OisinS13/Peltier_rig/Hardware/BOM.xlsx

Sheet: Purchasing BOM
Sub_assembly | Quantity | Reference | Quantity | Value | Supplier | Datasheet | Description | Height | Manufacturer_Name | Manufacturer_Part_Number | Supplier Part Number | Mouser Price/Stock | Total cost | Cost per unit
Grand total |  |  |  |  |  |  |  |  |  |  |  |  | 1511.86 | 302.372
Controller | 5 |  |  |  |  |  |  |  |  |  |  |  | 195.21 | 39.042
 |  | A1 | 5 | Adafruit_Feather_Generic | Mouser | https://www.mouser.co.uk/datasheet/2/737/adafruit_adalogger_featherwing-1915269.pdf | Adafruit Accessories Adalogger FeatherWing - RTC + SD Add-on For All Feather Boards | 0 | Adafruit | 2922 | 485-2922 | 6.91 | 34.55
 |  | IC1 | 5 | MAX22531AAP+ | Mouser | https://datasheets.maximintegrated.com/en/ds/MAX22530.pdf | Field-Side Self-Powered, 4-Channel, 12-bit, Isolated ADC, 20-pin SSOP | 1.99 | Maxim Integrated | MAX22531AAP+ | 700-MAX22531AAP+ | 8.43 | 42.15
 |  | IC3 | 5 | MCP3304-CI_P | Mouser | 0 | Microchip MCP3304-CI/P, 13 bit Serial ADC, Differential Input, 16-Pin PDIP | 5.334 | Microchip | MCP3304-CI/P | 579-MCP3304-CI/P | 4.05 | 20.25
 |  | J1 J4 | 10 | Cell_V,T_Fuse | Mouser | https://www.phoenixcontact.com/us/products/1881558/pdf | Pluggable Terminal Blocks 2 Pos 2.5mm pitch Through Hole Header | 13.6 | Phoenix Contact | 1881558 | 651-1881558 | 0.926 | 9.26
 |  | J10 | 5 | NTC_ADC_Conn | Mouser | https://www.mouser.co.uk/datasheet/2/527/ssw_th-2854740.pdf | Headers & Wire Housings Tiger Buy Socket Strip with PCB Tails, .100" Pitch | 0 | Samtec | SSW-106-01-T-S | 200-SSW10601TS | 0.81 | 4.05
 |  | J11 | 5 | NTC_ADC_CS_Conn | Mouser | https://www.mouser.co.uk/datasheet/2/527/ssw_th-2854740.pdf | Headers & Wire Housings Tiger Buy Socket Strip with PCB Tails, .100" Pitch | 0 | Samtec | SSW-108-01-T-D | 200-SSW10801TD | 1.47 | 7.35
 |  | J2 J3 | 10 | I_sense_0, I_sense_1 | Mouser | https://www.phoenixcontact.com/us/products/1881451/pdf | Pluggable Terminal Blocks 3 Pos 2.5mm pitch Through Hole Header | 0 | Phoenix Contact | 1881561 | 651-1881561 | 1.05 | 10.5
 |  | J8 | 5 | LCD | Mouser | https://www.phoenixcontact.com/us/products/1881574/pdf | Pluggable Terminal Blocks 4 Pos 2.5mm pitch Through Hole Header | 0 | Phoenix Contact | 1881574 | 651-1881574 | 1.41 | 7.05
 |  | J9 | 5 | NTC_Conn | Mouser | https://tools.molex.com/pdm_docs/sd/430451622_sd.pdf | Headers & Wire Housings Microfit 3.0 RA PTH clip 15Au DR 16Ckt | 0 | Molex | 43045-1622 | 538-43045-1622 | 2.83 | 14.15
 |  | PS1 | 5 | TEA_1-0505 | Mouser | https://tracopower.com/tea1-datasheet/ | 1 Watt DC/DC converter, industrial, +/-10% input, unregulated, highly cost efficient, encapsulated, SIP-4 | 10.15 | Traco Power | TEA 1-0505 | 495-TEA1-0505 | 1.44 | 7.2
 |  | S1 S2 | 10 | DS01C-254-S-08BE | Mouser | 0 | DIP Switches / SIP Switches DIP Switch, SPST, 2.54 pitch, raised actuator, covex bottom, Short pin, 8 position, Blue | 7 | CUI Devices | DS01C-254-S-08BE | 490-DS01C-254-S-08BE | 0.571 | 5.71
 |  | U1 | 5 | Pico | Mouser | https://www.mouser.co.uk/datasheet/2/635/pico_datasheet-3048936.pdf | Single Board Computers Raspberry Pi Pico | 0 | Raspberry Pi | SC0915 | 358-SC0915 | 3.09 | 15.45
 |  | U2 U3 U4 | 15 | PXO7805-500-S | Mouser | https://www.mouser.co.uk/datasheet/2/670/pxo78_500_s-3070528.pdf | Non-Isolated DC/DC Converters dc-dc non-isolated, 0.5 A, 6.5-36 Vdc input, 5 Vdc output, SIP | 0 | CUI Inc. | PXO7805-500-S | 490-PXO7805-500-S | 1.11 | 16.65
 |  | Socket | 5 | 0 | Mouser | https://www.mouser.co.uk/datasheet/2/418/7/ENG_CD_2199298_A_baseFilename-2029528.pdf | IC & Component Sockets 16P DIP SKT 300 CL LADDER | 0 | TE Connectivity | 1-2199298-4 | 571-1-2199298-4 | 0.177 | 0.89
 |  | Socket header 12pos | 5 | 0 | Mouser | https://www.mouser.co.uk/datasheet/2/527/ssw_th-2854740.pdf | 0 | 0 | Samtec | SSW-112-01-T-S | 200-SSW11201TS | 1.48 | 7.4
 |  | Socket header 16pos | 5 | 0 | Mouser | https://www.mouser.co.uk/datasheet/2/527/ssw_th-2854740.pdf | Headers & Wire Housings Tiger Buy Socket Strip with PCB Tails, .100" Pitch | 0 | Samtec | SSW-116-01-T-S | 200-SSW11601TS | 1.89 | 9.45
 |  | Standoff | 20 | M3 x 8mm | Mouser | https://www.mouser.co.uk/datasheet/2/181/R30_300-1136135.pdf | Standoffs & Spacers M3 x 8mm HEX 5mm A/F 6mm ML/FML NICKEL | 0 | Harwin | R30-3011202 | 855-R30-3011202 | 0.504 | 10.08
 |  | SD card | 5 | 0 | Mouser | https://www.mouser.co.uk/datasheet/2/669/SanDisk_10092017_iNAND-Family-Brochure-for-M_C_022-1217148.pdf | Memory Cards 16GB UHS Class 4 MicroSD Card WD/SD | 0 | SanDisk | SDSDQAB-016G | 467-SDSDQAB-016G | 10.31 | 51.55
Driver | 5 |  |  |  |  |  |  |  |  |  |  |  | 308.07 | 61.614
 |  | C1 C2 C3 C4 C9 C10 C11 C12 | 40 | 47uF | Mouser | https://product.tdk.com/info/en/catalog/datasheets/leadmlcc_halogenfree_fg_en.pdf | Multilayer Ceramic Capacitors MLCC - Leaded RAD 25V 47uF X5R 20% LS:2.5mm | 0 | TDK | FG16X5R1E476MRT06 | 810-FG16X5R1E476MRT6 | 0.671 | 26.84
 |  | C22 C23 C24 C25 C26 C27 C28 C29 | 40 | 220uF | Mouser | https://www.mouser.co.uk/datasheet/2/231/161587830771-2307470.pdf | Aluminium Electrolytic Capacitors - Radial Leaded 25V 220uF 105C 8x11.5mm | 11.5 | Lelon | RGA221M1EBK-0811G | 140-RGA221M1EBK0811G | 0.102 | 4.08
 |  | U2 | 5 | Adafruit_815_I2C_PWM_driver | Mouser | https://www.mouser.co.uk/datasheet/2/737/PCA9685-932827.pdf | Power Management IC Development Tools PWM/Servo Driver PCA9685 12-bit | 0 | Adafruit | 815 | 485-815 | 11.54 | 57.7
 |  | J7 J12 | 10 | Conn_02x04_Odd_Even
 |  | 0 | 40 | 1377G11 | Mouser | https://www.mouser.co.uk/datasheet/2/22/DS_PP1545-1664114.pdf | Heavy Duty Power Connectors R/A PCB CONT 25A LD 0.70" - BULK | 0 | Anderson Power Products | 1377g11-bk | 879-1377G11-BK | 1.24 | 49.6
 |  | 0 | 40 | 1377G12 | Mouser | https://www.mouser.co.uk/datasheet/2/22/DS_PP1545-1664114.pdf | Heavy Duty Power Connectors R/A PCB CONT 25A LD 0.40" - BULK | 0 | Anderson Power Products | 1377g12-bk | 879-1377G12-BK | 1.24 | 49.6
 |  | 0 | 40 | 1327-BK | Mouser | https://www.mouser.co.uk/datasheet/2/22/DS_PP1545-1664114.pdf | Heavy Duty Power Connectors PP15/45 HOUSING ONLY RED - BULK | 0 | Anderson Power Products | 1327-BK | 879-1327-BK | 0.638 | 25.52
 |  | 0 | 40 | 1327G6-BK | Mouser | https://www.mouser.co.uk/datasheet/2/22/DS_PP1545-1664114.pdf | Heavy Duty Power Connectors PP15/45 HOUSING ONLY BLACK - BULK | 0 | Anderson Power Products | 1327G6-BK | 879-1327G6-BK | 0.586 | 23.44
 |  | 0 | 10 | Retaining pin | Mouser | https://www.mouser.co.uk/datasheet/2/22/DS_PP1545-1664114.pdf | Heavy Duty Power Connectors RETAINING PIN PER DWG TR1716 | 0 | Anderson Power Products | 111812P5 | 879-111812P5 | 0.189 | 1.89
 |  | 0 | 10 | Solder staple | Mouser | https://www.mouser.co.uk/datasheet/2/22/DS_PP1545-1664114.pdf | Heavy Duty Power Connectors PP15/45 23MM X 13.5MM STAPLE | 0 | Anderson Power Products | 114555P9 | 879-114555P9 | 1.01 | 10.1
 |  | 0 | 10 | Header socket 1x6 | Mouser | https://www.mouser.co.uk/datasheet/2/527/ssw_th-2854740.pdf | Headers & Wire Housings Tiger Buy Socket Strip with PCB Tails, .100" Pitch | 0 | Samtec | SSW-106-01-T-S | 200-SSW10601TS | 0.81 | 8.1
 |  | 0 | 20 | Header socket 3x4 | Mouser | https://www.mouser.co.uk/datasheet/2/527/ssw_th-2854740.pdf | Headers & Wire Housings Tiger Buy Socket Strip with PCB Tails, .100" Pitch | 0 | Samtec | SSW-104-03-F-T | 200-SSW10403FT | 2.56 | 51.2
Backplane | 5 |  |  |  |  |  |  |  |  |  |  |  | 233.49 | 46.698
 |  | C1 | 5 | 220uF | Mouser | https://www.mouser.co.uk/datasheet/2/231/161587830771-2307470.pdf | Aluminium Electrolytic Capacitors - Radial Leaded 25V 220uF 105C 8x11.5mm | 11.5 | Lelon | RGA221M1EBK-0811G | 140-RGA221M1EBK0811G | 0.102 | 0.51
 |  | J1 J2 J3 J4 J6 J7 J8 J9 | 40 | Conn_02x12_Odd_Even | Mouser | https://www.te.com/commerce/DocumentDelivery/DDEController?Action=srchrtrv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 | Standard Card Edge Connectors CONN SEC II 12 POS 100C/L | 0 | TE Connectivity | 5530843-1 | 571-5530843-1 | 1.95 | 78
 |  | J10 J11 J15 | 15 | 10046971-001LF | Mouser | https://cdn.amphenol-cs.com/media/wysiwyg/files/drawing/10046971.pdf | Power Edge Card connector, Power connectors, 2 x 32P STB Vertical | 15.49 | Amphenol Communications Solutions | 10046971-001LF | 649-10046971-001LF | 8.54 | 128.1
 |  | J12 J13 J14 | 15 | Power_switch, MCU_PWR_LED, MAIN_PWR_LED | Mouser | https://www.phoenixcontact.com/us/products/1881558/pdf | Pluggable Terminal Blocks 2 Pos 2.5mm pitch Through Hole Header | 13.6 | Phoenix Contact | 1881558 | 651-1881558 | 0.926 | 13.89
 |  | J5 | 5 | Backplane_edge_conn | Mouser | https://www.te.com/commerce/DocumentDelivery/DDEController?Action=srchrtrv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 | Standard Card Edge Connectors CONN SEC II 12 POS 100C/L | 0 | TE Connectivity | 7-5530843-5 | 571-7-5530843-5 | 2.19 | 10.95
 |  | R1 R2 R3 | 15 | 22k | Mouser | https://www.mouser.co.uk/datasheet/2/447/YAGEO_MFR_datasheet_2021v1-3003041.pdf | Metal Film Resistors - Through Hole 22.1K OHM 1/4W 1% | 0 | YAGEO | MFR-25FTE52-22K1 | 603-MFR-25FTE52-22K1 | 0.077 | 1.16
 |  | R4 | 5 | 100 | Mouser | https://www.koaspeer.com/catimages/Products/MF-MFS-RK/MF-MFS-RK.pdf | Metal Film Resistors - Through Hole 1/4 WATT 100 OHM 2% | 0 | KOA Speer | MF1/4LCT52R101G | 660-MF1/4LCT52R101G | 0.087 | 0.44
 |  | R5 | 5 | 200 | Mouser | https://www.koaspeer.com/catimages/Products/MF-MFS-RK/MF-MFS-RK.pdf | Metal Film Resistors - Through Hole 1/4 WATT 200 OHM 2% | 0 | KOA Speer | MF1/4LCT52R201G | 660-MF1/4LCT52R201G | 0.087 | 0.44
NTC_in | 5 |  |  |  |  |  |  |  |  |  |  |  | 58.69 | 11.738
 |  | IC3 | 5 | MCP3304-CI_P | Mouser | 0 | Microchip MCP3304-CI/P, 13 bit Serial ADC, Differential Input, 16-Pin PDIP | 5.334 | Microchip | MCP3304-CI/P | 579-MCP3304-CI/P | 4.05 | 20.25
 |  | J9 | 5 | NTC_Conn | Mouser | https://tools.molex.com/pdm_docs/sd/430451622_sd.pdf | Headers & Wire Housings Microfit 3.0 RA PTH clip 15Au DR 16Ckt | 0 | Molex | 43045-1622 | 538-43045-1622 | 2.83 | 14.15
 |  | S1 S2 | 10 | DS01C-254-S-08BE | Mouser | 0 | DIP Switches / SIP Switches DIP Switch, SPST, 2.54 pitch, raised actuator, covex bottom, Short pin, 8 position, Blue | 7 | CUI Devices | DS01C-254-S-08BE | 490-DS01C-254-S-08BE | 0.571 | 5.71
 |  | J10 11 | 5 | Stacking headers | Mouser | 0 | Headers & Wire Housings STACKING HEADER 1 X 26 PIN | 0 | Mikroe | MIKROE-1329 | 932-MIKROE-1329 | 1.7 | 8.5
 |  | Standoff | 20 | M3 x 8mm | Mouser | https://www.mouser.co.uk/datasheet/2/181/R30_300-1136135.pdf | Standoffs & Spacers M3 x 8mm HEX 5mm A/F 6mm ML/FML NICKEL | 0 | Harwin | R30-3011202 | 855-R30-3011202 | 0.504 | 10.08
Enclosure | 5 |  |  |  |  |  |  |  |  |  |  |  | 365.7
 |  | Enclosure | 5 | 0 | Farnell | 0 | 0 | 0 | MULTICOMP PRO | G17082UG | 1526721 | 25.68 | 128.4
 |  | USB socket | 5 | 0 | RS | 0 | 0 | 0 | RS PRO | 862-1573 | 862-1573 | 4.97 | 24.85
 |  | Micro USB cable | 5 | 0 | Mouser | 0 | 0 | 0 | Tripp Lite | UR05C-003-RB | 545-UR05C-003-RB | 7.96 | 39.8
 |  | LCD | 5 | 0 | Mouser | 0 | 0 | 0 | Seeed Studio | 104030001 | 713-104030001 | 10.53 | 52.65
 |  | PSU | 10 | 0 | https://www.bargainhardware.co.uk/ | 0 | 0 | 0 | HP | DPS-1200FB | PSU0000050 | 12 | 120
 |  | PSU carriage | 5 | 0 | 0 | 0 | 0 | 0 | 0 | 0 | 0 | 7.19 | 35.95
Boards | 5 |  |  |  |  |  |  |  |  |  |  |  | 350.7 | 70.14
 |  | Controller |  |  |  |  |  |  |  |  |  |  | 72.46 | 14.492
 |  | NTC in |  |  |  |  |  |  |  |  |  |  | 29.36 | 5.872
 |  | Driver |  |  |  |  |  |  |  |  |  |  | 193.11 | 38.622
 |  | Backplane |  |  |  |  |  |  |  |  |  |  | 30.27 | 6.054
 |  | Shipping |  |  |  |  |  |  |  |  |  |  | 25.5

Sheet: Enclosure
Component | Quantity | Value | Supplier | Datasheet | Description | Height | Manufacturer_Name | Manufacturer_Part_Number | Supplier SKU | Price
Enclosure | 1 |  | Farnell |  |  |  | MULTICOMP PRO | G17082UG | 1526721 | 25.68
USB socket | 1 |  | RS |  |  |  | RS PRO | 862-1573 | 862-1573 | 4.97
Micro USB cable | 1 |  | Mouser |  |  |  | Tripp Lite | UR05C-003-RB | 545-UR05C-003-RB | 7.96
LCD | 1 |  | Mouser |  |  |  | Seeed Studio | 104030001 | 713-104030001 | 10.53
PSU | 2 |  | https://www.bargainhardware.co.uk/ |  |  |  | HP | DPS-1200FB | PSU0000050 | 12
PSU carriage | 1 |  |  |  |  |  |  |  |  | 7.19
LCD mounting screws | 4
LCD mounting nuts | 8
USB mounting screws

Sheet: CCC_rig_NTC_in
Reference | Quantity | Value | Footprint | Datasheet | Description | Height | Manufacturer_Name | Manufacturer_Part_Number | Mouser Part Number | Mouser Price/Stock
IC2 | 1 | MCP1501T-33E_CHY | SamacSys_Parts:SOT95P270X145-6N | https://componentsearchengine.com/Datasheets/1/MCP1501T-33E_CHY.pdf | Voltage References Precision Buffered Voltage Reference | 1.45 | Microchip | MCP1501T-33E/CHY | 579-MCP1501T-33E/CHY | 0.771 (https://www.mouser.co.uk/ProductDetail/Microchip-Technology-Atmel/MCP1501T-33E-CHY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)
IC3 | 1 | MCP3304-CI_P | SamacSys_Parts:DIP781W56P254L1918H533Q16N |  | Microchip MCP3304-CI/P, 13 bit Serial ADC, Differential Input, 16-Pin PDIP | 5.334 | Microchip | MCP3304-CI/P | 579-MCP3304-CI/P | 4.05 (https://www.mouser.co.uk/ProductDetail/Microchip-Technology/MCP3304-CI-P?qs=2HbNQnvoB68T7LZcGwqiOg%3D%3D)
J9 | 1 | NTC_Conn | SamacSys_Parts:43045-16YY_212223 | https://tools.molex.com/pdm_docs/sd/430451622_sd.pdf | Headers & Wire Housings Microfit 3.0 RA PTH clip 15Au DR 16Ckt |  | Molex | 43045-1622 | 538-43045-1622 | 2.83
S1 S2 | 2 | DS01C-254-S-08BE | SamacSys_Parts:DS01C254S08BE |  | DIP Switches / SIP Switches DIP Switch, SPST, 2.54 pitch, raised actuator, covex bottom, Short pin, 8 position, Blue | 7 | CUI Devices | DS01C-254-S-08BE | 490-DS01C-254-S-08BE | 0.571
J10 11 | 1 | Stacking headers |  |  | Headers & Wire Housings STACKING HEADER 1 X 26 PIN |  | Mikroe | MIKROE-1329 | 932-MIKROE-1329 | 1.7
Standoff | 4 | M3 x 8mm |  | https://www.mouser.co.uk/datasheet/2/181/R30_300-1136135.pdf | Standoffs & Spacers M3 x 8mm HEX 5mm A/F 6mm ML/FML NICKEL |  | Harwin | R30-3011202 | 855-R30-3011202 | 0.504

Sheet: NTC_in_SMD_BOM
Comment | Designator | Footprint | JLCPCB Part #（optional）
10 nF | C11 C12 C13 C14 C15 C16 C17 C18 C19 C20 | Capacitor_SMD:C_0603_1608Metric_Pad1.08x0.95mm_HandSolder | C302008
1 uF | C21 | Capacitor_SMD:C_0603_1608Metric_Pad1.08x0.95mm_HandSolder | C15849
6.8k | R12 R13 R14 R15 R16 R17 R18 R19 | Resistor_SMD:R_0603_1608Metric_Pad0.98x0.95mm_HandSolder | C445634
REF3433IDBVR | IC2 | SamacSys_Parts:SOT95P280X145-6N | C882722

Sheet: NTC_in_SMD_SMT
Designator | Mid X | Mid Y | Layer | Rotation
C11 | 26.9 | -88.056 | top | 180
C12 | 31.9 | -88.056 | top | 180
C13 | 36.9 | -88.056 | top | 180
C14 | 41.9 | -88.056 | top | 180
C15 | 46.9 | -88.056 | top | 180
C16 | 51.9 | -88.056 | top | 180
C17 | 56.9 | -88.056 | top | 180
C18 | 61.9 | -88.056 | top | 180
C19 | 36.364 | -74.092 | top | 90
C20 | 27.728 | -74.092 | top | 90
C21 | 32.3 | -69.52 | top | 0
IC2 | 32.3 | -74.6 | top | 90
R12 | 26.9 | -84.5 | top | 180
R13 | 31.9 | -84.5 | top | 180
R14 | 36.9 | -84.5 | top | 180
R15 | 41.9 | -84.5 | top | 180
R16 | 46.9 | -84.5 | top | 180
R17 | 51.9 | -84.5 | top | 180
R18 | 56.9 | -84.5 | top | 180
R19 | 61.9 | -84.5 | top | 180

Sheet: CCC_rig_driver
Reference | Quantity | Value | Footprint | Datasheet | Description | Height | Manufacturer_Name | Manufacturer_Part_Number | Mouser Part Number | Mouser Price/Stock
C1 C2 C3 C4 C9 C10 C11 C12 | 8 | 47uF | Capacitor_THT:CP_Radial_D5.0mm_P2.50mm | https://product.tdk.com/info/en/catalog/datasheets/leadmlcc_halogenfree_fg_en.pdf | Multilayer Ceramic Capacitors MLCC - Leaded RAD 25V 47uF X5R 20% LS:2.5mm |  | TDK | FG16X5R1E476MRT06 | 810-FG16X5R1E476MRT6 | 0.671
C22 C23 C24 C25 C26 C27 C28 C29 | 8 | 220uF | Capacitor_THT:CP_Radial_D8.0mm_P3.50mm | https://www.mouser.co.uk/datasheet/2/231/161587830771-2307470.pdf | Aluminium Electrolytic Capacitors - Radial Leaded 25V 220uF 105C 8x11.5mm | 11.5 | Lelon | RGA221M1EBK-0811G | 140-RGA221M1EBK0811G | 0.102
U2 | 1 | Adafruit_815_I2C_PWM_driver | Arduino:MODULE_815 | https://www.mouser.co.uk/datasheet/2/737/PCA9685-932827.pdf | Power Management IC Development Tools PWM/Servo Driver PCA9685 12-bit |  | Adafruit | 815 | 485-815 | 11.54
J7 J12 | 2 | Conn_02x04_Odd_Even | SamacSys_Parts:Anderson_PCB_mount_P1545_2x4
 | 8 | 1377G11 |  | https://www.mouser.co.uk/datasheet/2/22/DS_PP1545-1664114.pdf | Heavy Duty Power Connectors R/A PCB CONT 25A LD 0.70" - BULK |  | Anderson Power Products | 1377g11-bk | 879-1377G11-BK | 1.24
 | 8 | 1377G12 |  | https://www.mouser.co.uk/datasheet/2/22/DS_PP1545-1664114.pdf | Heavy Duty Power Connectors R/A PCB CONT 25A LD 0.40" - BULK |  | Anderson Power Products | 1377g12-bk | 879-1377G12-BK | 1.24
 | 8 | 1327-BK |  | https://www.mouser.co.uk/datasheet/2/22/DS_PP1545-1664114.pdf | Heavy Duty Power Connectors PP15/45 HOUSING ONLY RED - BULK |  | Anderson Power Products | 1327-BK | 879-1327-BK | 0.638
 | 8 | 1327G6-BK |  | https://www.mouser.co.uk/datasheet/2/22/DS_PP1545-1664114.pdf | Heavy Duty Power Connectors PP15/45 HOUSING ONLY BLACK - BULK |  | Anderson Power Products | 1327G6-BK | 879-1327G6-BK | 0.586
 | 2 | Retaining pin |  | https://www.mouser.co.uk/datasheet/2/22/DS_PP1545-1664114.pdf | Heavy Duty Power Connectors RETAINING PIN PER DWG TR1716 |  | Anderson Power Products | 111812P5 | 879-111812P5 | 0.189
 | 2 | Solder staple |  | https://www.mouser.co.uk/datasheet/2/22/DS_PP1545-1664114.pdf | Heavy Duty Power Connectors PP15/45 23MM X 13.5MM STAPLE |  | Anderson Power Products | 114555P9 | 879-114555P9 | 1.01
 | 2 | Header socket 1x6 |  | https://www.mouser.co.uk/datasheet/2/527/ssw_th-2854740.pdf | Headers & Wire Housings Tiger Buy Socket Strip with PCB Tails, .100" Pitch |  | Samtec | SSW-106-01-T-S | 200-SSW10601TS | 0.81
 | 4 | Header socket 3x4 |  | https://www.mouser.co.uk/datasheet/2/527/ssw_th-2854740.pdf | Headers & Wire Housings Tiger Buy Socket Strip with PCB Tails, .100" Pitch |  | Samtec | SSW-104-03-F-T | 200-SSW10403FT | 2.56

Sheet: Driver_SMD_BOM
Comment | Designator | Footprint | JLCPCB Part #（optional）
VNH7070ASTR | SamacSys_Parts:SOIC127P600X175-16N-layout | SamacSys_Parts:SOIC127P600X175-16N-layout | C2150622
BSS138 | Q3 Q4 Q5 Q6 Q7 Q8 Q9 Q10 | Package_TO_SOT_SMD:SOT-23 | C112239
8.06k | R20 R21 R22 R23 R24 R25 R26 R27 | Resistor_SMD:R_0603_1608Metric_Pad0.98x0.95mm_HandSolder | C861587
1k | R28 R29 R30 R31 R32 R33 R34 R35 R36 R37 R38 R39 R40 R41 R42 R43 R44 R45 R46 R47 R48 R49 R50 R51 | Resistor_SMD:R_0603_1608Metric_Pad0.98x0.95mm_HandSolder | C22548

Sheet: Driver_SMD_SMT
Designator | Mid X | Mid Y | Layer | Rotation
IC4 | 26.4175 | -30.1876 | top | 90
IC5 | 33.0361 | -49.5528 | top | 90
IC6 | 39.6547 | -68.918 | top | 90
IC7 | 46.2733 | -88.2832 | top | 90
IC8 | 58.2477 | -150.0569 | top | -90
IC9 | 64.6644 | -130.6917 | top | -90
IC10 | 71.081 | -111.3265 | top | -90
IC11 | 77.4977 | -91.9613 | top | -90
J6 | 48 | -11.9946 | top | 180
Q3 | 39.6675 | -26.0251 | top | 0
Q4 | 46.2861 | -45.3903 | top | 0
Q5 | 52.9047 | -64.7555 | top | 0
Q6 | 59.5233 | -84.1207 | top | 0
Q7 | 50.5 | -157.9 | top | 180
Q8 | 51.4144 | -134.8542 | top | 180
Q9 | 57.831 | -115.489 | top | 180
Q10 | 64.2477 | -96.1238 | top | 180
R20 | 35.6675 | -26.0251 | top | -90
R21 | 42.2861 | -45.3903 | top | -90
R22 | 48.9047 | -64.7555 | top | -90
R23 | 55.5233 | -84.1207 | top | -90
R24 | 48.9977 | -154.2194 | top | 90
R25 | 55.4144 | -134.8542 | top | 90
R26 | 61.831 | -115.489 | top | 90
R27 | 68.2477 | -96.1238 | top | 90
R28 | 33.505 | -32.1876 | top | 180
R29 | 40.1236 | -51.5528 | top | 180
R30 | 46.7422 | -70.918 | top | 180
R31 | 53.3608 | -90.2832 | top | 180
R32 | 32.6675 | -26.0251 | top | -90
R33 | 39.2861 | -45.3903 | top | -90
R34 | 45.9047 | -64.7555 | top | -90
R35 | 52.5233 | -84.1207 | top | -90
R36 | 18.4175 | -28.4376 | top | 180
R37 | 25.0361 | -47.8028 | top | 180
R38 | 31.6547 | -67.168 | top | 180
R39 | 38.2733 | -86.5332 | top | 180
R40 | 51.1602 | -148.0569 | top | 0
R41 | 57.5769 | -128.6917 | top | 0
R42 | 63.9935 | -109.3265 | top | 0
R43 | 70.4102 | -89.9613 | top | 0
R44 | 51.9977 | -154.2194 | top | 90
R45 | 58.4144 | -134.8542 | top | 90
R46 | 64.831 | -115.489 | top | 90
R47 | 71.2477 | -96.1238 | top | 90
R48 | 66.2477 | -151.8069 | top | 0
R49 | 72.6644 | -132.4417 | top | 0
R50 | 79.0814 | -113.0767 | top | 0
R51 | 85.4977 | -93.7113 | top | 0

Sheet: CCC_rig_backplane
Reference | Quantity | Value | Footprint | Datasheet | Description | Height | Manufacturer_Name | Manufacturer_Part_Number | Mouser Part Number | Mouser Price/Stock
C1 | 1 | 220uF | Capacitor_THT:CP_Radial_D8.0mm_P3.50mm | https://www.mouser.co.uk/datasheet/2/231/161587830771-2307470.pdf | Aluminium Electrolytic Capacitors - Radial Leaded 25V 220uF 105C 8x11.5mm | 11.5 | Lelon | RGA221M1EBK-0811G | 140-RGA221M1EBK0811G | 0.102
J1 J2 J3 J4 J6 J7 J8 J9 | 8 | Conn_02x12_Odd_Even | SamacSys_Parts:55308431 | https://www.te.com/commerce/DocumentDelivery/DDEController?Action=srchrtrv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 | Standard Card Edge Connectors CONN SEC II 12 POS 100C/L |  | TE Connectivity | 5530843-1 | 571-5530843-1 | 1.95
J10 J11 J15 | 3 | 10046971-001LF | SamacSys_Parts:RHDR64W90P508X254_2X32_8786X929X1549P | https://cdn.amphenol-cs.com/media/wysiwyg/files/drawing/10046971.pdf | Power Edge Card connector, Power connectors, 2 x 32P STB Vertical | 15.49 | Amphenol Communications Solutions | 10046971-001LF | 649-10046971-001LF | 8.54
J12 J13 J14 | 3 | Power_switch, MCU_PWR_LED, MAIN_PWR_LED | SamacSys_Parts:1963531 | https://www.phoenixcontact.com/us/products/1881558/pdf | Pluggable Terminal Blocks 2 Pos 2.5mm pitch Through Hole Header | 13.6 | Phoenix Contact | 1881558 | 651-1881558 | 0.926
J5 | 1 | Backplane_edge_conn | SamacSys_Parts:755308435 | https://www.te.com/commerce/DocumentDelivery/DDEController?Action=srchrtrv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 | Standard Card Edge Connectors CONN SEC II 12 POS 100C/L |  | TE Connectivity | 7-5530843-5 | 571-7-5530843-5 | 2.19
R1 R2 R3 | 3 | 22k | Resistor_THT:R_Axial_DIN0207_L6.3mm_D2.5mm_P7.62mm_Horizontal | https://www.mouser.co.uk/datasheet/2/447/YAGEO_MFR_datasheet_2021v1-3003041.pdf | Metal Film Resistors - Through Hole 22.1K OHM 1/4W 1% |  | YAGEO | MFR-25FTE52-22K1 | 603-MFR-25FTE52-22K1 | 0.077
R4 | 1 | 100 | Resistor_THT:R_Axial_DIN0207_L6.3mm_D2.5mm_P7.62mm_Horizontal | https://www.koaspeer.com/catimages/Products/MF-MFS-RK/MF-MFS-RK.pdf | Metal Film Resistors - Through Hole 1/4 WATT 100 OHM 2% |  | KOA Speer | MF1/4LCT52R101G | 660-MF1/4LCT52R101G | 0.087
R5 | 1 | 200 | Resistor_THT:R_Axial_DIN0207_L6.3mm_D2.5mm_P7.62mm_Horizontal | https://www.koaspeer.com/catimages/Products/MF-MFS-RK/MF-MFS-RK.pdf | Metal Film Resistors - Through Hole 1/4 WATT 200 OHM 2% |  | KOA Speer | MF1/4LCT52R201G | 660-MF1/4LCT52R201G | 0.087

Sheet: CCC_rig_controller
Reference | Quantity | Value | Footprint | Datasheet | Description | Height | Manufacturer_Name | Manufacturer_Part_Number | Mouser Part Number | Mouser Price/Stock
A1 | 1 | Adafruit_Feather_Generic | Module:Adafruit_Feather | https://www.mouser.co.uk/datasheet/2/737/adafruit_adalogger_featherwing-1915269.pdf | Adafruit Accessories Adalogger FeatherWing - RTC + SD Add-on For All Feather Boards |  | Adafruit | 2922 | 485-2922 | 6.91
IC1 | 1 | MAX22531AAP+ | SamacSys_Parts:SOP65P778X199-20N | https://datasheets.maximintegrated.com/en/ds/MAX22530.pdf | Field-Side Self-Powered, 4-Channel, 12-bit, Isolated ADC, 20-pin SSOP | 1.99 | Maxim Integrated | MAX22531AAP+ | 700-MAX22531AAP+ | 8.43 (https://www.mouser.co.uk/ProductDetail/Maxim-Integrated/MAX22531AAP%2b?qs=doiCPypUmgFZ7xzUXZ7H2g%3D%3D)
IC3 | 1 | MCP3304-CI_P | SamacSys_Parts:DIP781W56P254L1918H533Q16N |  | Microchip MCP3304-CI/P, 13 bit Serial ADC, Differential Input, 16-Pin PDIP | 5.334 | Microchip | MCP3304-CI/P | 579-MCP3304-CI/P | 4.05 (https://www.mouser.co.uk/ProductDetail/Microchip-Technology/MCP3304-CI-P?qs=2HbNQnvoB68T7LZcGwqiOg%3D%3D)
J1 J4 | 2 | Cell_V,T_Fuse | SamacSys_Parts:1963531 | https://www.phoenixcontact.com/us/products/1881558/pdf | Pluggable Terminal Blocks 2 Pos 2.5mm pitch Through Hole Header | 13.6 | Phoenix Contact | 1881558 | 651-1881558 | 0.926
J10 | 1 | NTC_ADC_Conn | Connector_PinSocket_2.54mm:PinSocket_1x06_P2.54mm_Vertical | https://www.mouser.co.uk/datasheet/2/527/ssw_th-2854740.pdf | Headers & Wire Housings Tiger Buy Socket Strip with PCB Tails, .100" Pitch |  | Samtec | SSW-106-01-T-S | 200-SSW10601TS | 0.81
J11 | 1 | NTC_ADC_CS_Conn | Connector_PinSocket_2.54mm:PinSocket_2x08_P2.54mm_Vertical | https://www.mouser.co.uk/datasheet/2/527/ssw_th-2854740.pdf | Headers & Wire Housings Tiger Buy Socket Strip with PCB Tails, .100" Pitch |  | Samtec | SSW-108-01-T-D | 200-SSW10801TD | 1.47
J2 J3 | 2 | I_sense_0, I_sense_1 | SamacSys_Parts:1963544 | https://www.phoenixcontact.com/us/products/1881451/pdf | Pluggable Terminal Blocks 3 Pos 2.5mm pitch Through Hole Header |  | Phoenix Contact | 1881561 | 651-1881561 | 1.05
J8 | 1 | LCD | SamacSys_Parts:1963557 | https://www.phoenixcontact.com/us/products/1881574/pdf | Pluggable Terminal Blocks 4 Pos 2.5mm pitch Through Hole Header |  | Phoenix Contact | 1881574 | 651-1881574 | 1.41
J9 | 1 | NTC_Conn | SamacSys_Parts:43045-16YY_212223 | https://tools.molex.com/pdm_docs/sd/430451622_sd.pdf | Headers & Wire Housings Microfit 3.0 RA PTH clip 15Au DR 16Ckt |  | Molex | 43045-1622 | 538-43045-1622 | 2.83
PS1 | 1 | TEA_1-0505 | SamacSys_Parts:TEA10505 | https://tracopower.com/tea1-datasheet/ | 1 Watt DC/DC converter, industrial, +/-10% input, unregulated, highly cost efficient, encapsulated, SIP-4 | 10.15 | Traco Power | TEA 1-0505 | 495-TEA1-0505 | 1.44
S1 S2 | 2 | DS01C-254-S-08BE | SamacSys_Parts:DS01C254S08BE |  | DIP Switches / SIP Switches DIP Switch, SPST, 2.54 pitch, raised actuator, covex bottom, Short pin, 8 position, Blue | 7 | CUI Devices | DS01C-254-S-08BE | 490-DS01C-254-S-08BE | 0.571
U1 | 1 | Pico | MCU_RaspberryPi_and_Boards:RPi_Pico_SMD_TH | https://www.mouser.co.uk/datasheet/2/635/pico_datasheet-3048936.pdf | Single Board Computers Raspberry Pi Pico |  | Raspberry Pi | SC0915 | 358-SC0915 | 3.09
U2 U3 U4 | 3 | PXO7805-500-S | SamacSys_Parts:PXO7805-500-S | https://www.mouser.co.uk/datasheet/2/670/pxo78_500_s-3070528.pdf | Non-Isolated DC/DC Converters dc-dc non-isolated, 0.5 A, 6.5-36 Vdc input, 5 Vdc output, SIP |  | CUI Inc. | PXO7805-500-S | 490-PXO7805-500-S | 1.11
Socket | 1 |  |  | https://www.mouser.co.uk/datasheet/2/418/7/ENG_CD_2199298_A_baseFilename-2029528.pdf | IC & Component Sockets 16P DIP SKT 300 CL LADDER |  | TE Connectivity | 1-2199298-4 | 571-1-2199298-4 | 0.177
Socket header 12pos | 1 |  |  | https://www.mouser.co.uk/datasheet/2/527/ssw_th-2854740.pdf |  |  | Samtec | SSW-112-01-T-S | 200-SSW11201TS | 1.48
Socket header 16pos | 1 |  |  | https://www.mouser.co.uk/datasheet/2/527/ssw_th-2854740.pdf | Headers & Wire Housings Tiger Buy Socket Strip with PCB Tails, .100" Pitch |  | Samtec | SSW-116-01-T-S | 200-SSW11601TS | 1.89
Standoff | 4 | M3 x 8mm |  | https://www.mouser.co.uk/datasheet/2/181/R30_300-1136135.pdf | Standoffs & Spacers M3 x 8mm HEX 5mm A/F 6mm ML/FML NICKEL |  | Harwin | R30-3011202 | 855-R30-3011202 | 0.504
SD card | 1 |  |  | https://www.mouser.co.uk/datasheet/2/669/SanDisk_10092017_iNAND-Family-Brochure-for-M_C_022-1217148.pdf | Memory Cards 16GB UHS Class 4 MicroSD Card WD/SD |  | SanDisk | SDSDQAB-016G | 467-SDSDQAB-016G | 10.31

Sheet: Controller_SMD_BOM
Comment | Designator | Footprint | JLCPCB Part #（optional）
10 nF | C1 C2 C3 C6 C7 C10 C11 C12 C13 C14 C15 C16 C17 C18 C19 C20 | Capacitor_SMD:C_0603_1608Metric_Pad1.08x0.95mm_HandSolder | C302008
1 uF | C4 C5 C8 C21 | Capacitor_SMD:C_0603_1608Metric_Pad1.08x0.95mm_HandSolder | C15849
22 pF | C9 | Capacitor_SMD:C_0603_1608Metric_Pad1.08x0.95mm_HandSolder | C105620
BSS138 | Q1 Q2 | Package_TO_SOT_SMD:SOT-23 | C112239
14k | R1 R3 R4 | Resistor_SMD:R_0603_1608Metric_Pad0.98x0.95mm_HandSolder | C705811
6.8k | R12 R13 R14 R15 R16 R17 R18 R19 | Resistor_SMD:R_0603_1608Metric_Pad0.98x0.95mm_HandSolder | C445634
12k | R2 | Resistor_SMD:R_0603_1608Metric_Pad0.98x0.95mm_HandSolder | C413722
8.06k | R5 R6 R7 | Resistor_SMD:R_0603_1608Metric_Pad0.98x0.95mm_HandSolder | C861587
5.6k | R8 R9 R10 R11 | Resistor_SMD:R_0603_1608Metric_Pad0.98x0.95mm_HandSolder | C351638
REF3433IDBVR | IC2 | SamacSys_Parts:SOT95P280X145-6N | C882722

Sheet: Controller_SMD_SMT
Designator | Mid X | Mid Y | Layer | Rotation
C1 | 76.392 | -39.9633 | top | 90
C2 | 73.344 | -39.8098 | top | 90
C3 | 70.296 | -39.8098 | top | 90
C4 | 67.248 | -39.8098 | top | 90
C5 | 79.44 | -39.9633 | top | -90
C6 | 64.2 | -39.8098 | top | 90
C7 | 82.488 | -39.9633 | top | -90
C8 | 69.128 | -52.6138 | top | 90
C9 | 79.128 | -55.6138 | top | 180
C10 | 66.08 | -52.6138 | top | 90
C11 | 50.7 | -179.956 | top | 180
C12 | 55.7 | -179.956 | top | 180
C13 | 60.7 | -179.956 | top | 180
C14 | 65.7 | -179.956 | top | 180
C15 | 70.7 | -179.956 | top | 180
C16 | 75.7 | -179.956 | top | 180
C17 | 80.7 | -179.956 | top | 180
C18 | 85.7 | -179.956 | top | 180
C19 | 60.164 | -165.992 | top | 90
C20 | 51.528 | -165.992 | top | 90
C21 | 56.1 | -161.42 | top | 0
Q1 | 84.024 | -81.7808 | top | 0
Q2 | 84 | -92.2088 | top | 0
R1 | 78.5 | -69.6263 | top | -90
R2 | 76.392 | -34.7298 | top | -90
R3 | 70.296 | -34.7298 | top | -90
R4 | 64.2 | -34.7298 | top | -90
R5 | 79.44 | -34.7298 | top | 90
R6 | 73.344 | -34.7298 | top | 90
R7 | 67.248 | -34.7298 | top | 90
R8 | 88.596 | -81.7808 | top | 90
R9 | 82.5 | -77.2088 | top | -90
R10 | 88.5 | -92.7888 | top | 90
R11 | 82.5 | -87.7088 | top | -90
R12 | 50.7 | -176.4 | top | 180
R13 | 55.7 | -176.4 | top | 180
R14 | 60.7 | -176.4 | top | 180
R15 | 65.7 | -176.4 | top | 180
R16 | 70.7 | -176.4 | top | 180
R17 | 75.7 | -176.4 | top | 180
R18 | 80.7 | -176.4 | top | 180
R19 | 85.7 | -176.4 | top | 180
IC2 | 56.1 | -166.5 | top | 90
