OisinS13/Peltier_rig/Hardware/CCC_rig_backplane/CAD_sketch.dxf

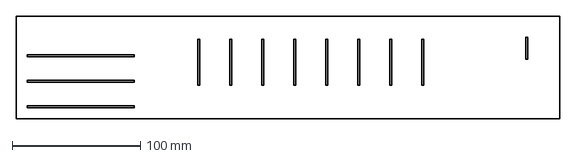
[picture p1: CAD file, 2023-10-16]
Hardware/CCC_rig_backplane/CAD_sketch.dxf
424.0 x 80.0 mm
