OisinS13/Peltier_rig/Hardware/CCC_rig_driver/CCC_rig_driver.step

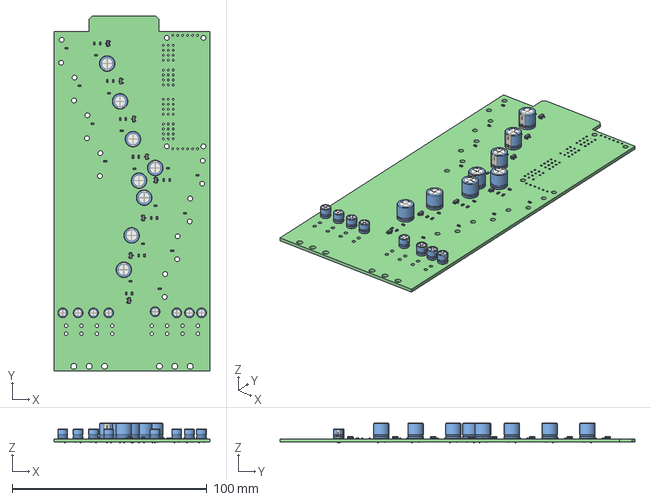
[picture p2: CAD file, 2023-10-16]
Hardware/CCC_rig_driver/CCC_rig_driver.step
80.0 x 182.0 x 10.0 mm
CCC_rig_driver PCB
