OisinS13/Peltier_rig/Hardware/CCC_rig_NTC_in/CCC_rig_NTC_in.step

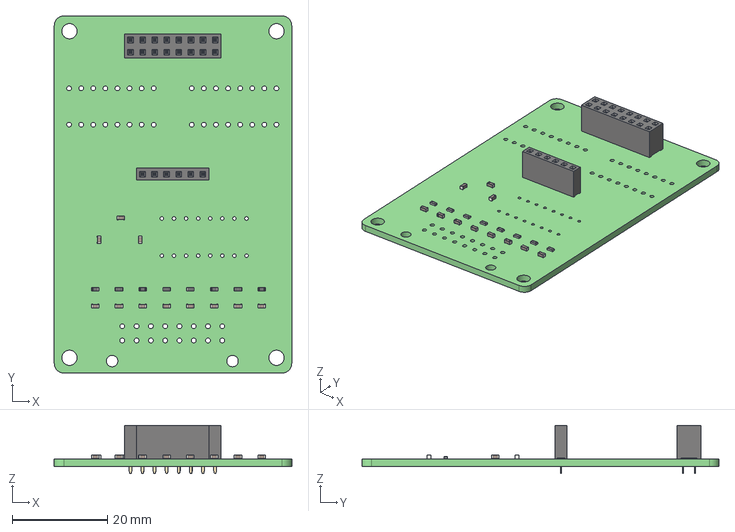
[picture p3: CAD file, 2023-10-16]
Hardware/CCC_rig_NTC_in/CCC_rig_NTC_in.step
49.9 x 75.0 x 10.1 mm
CCC_rig_NTC_in PCB
