OisinS13/Peltier_rig/Hardware/CCC_rig_NTC_in/Fab_outs_NTC/CCC_rig_NTC_in-NPTH-drl-drl_map.dxf

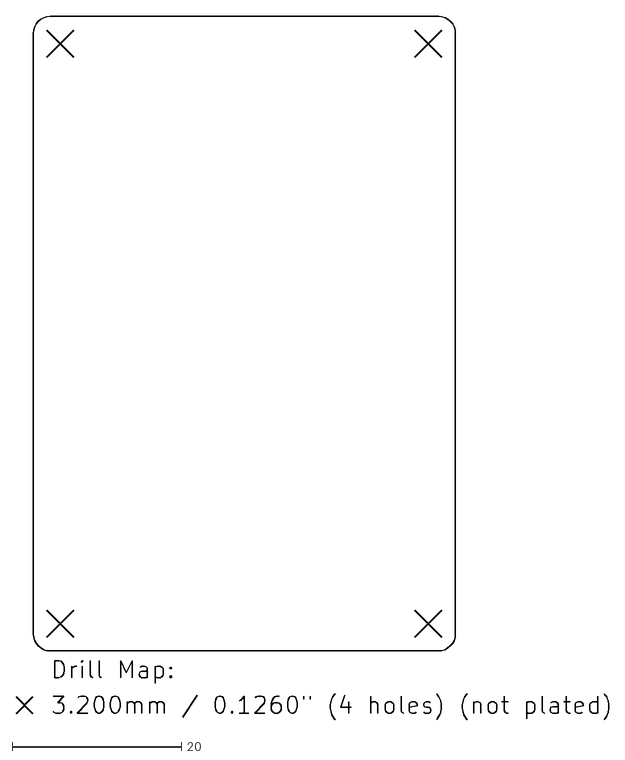
[picture p4: CAD file, 2023-10-16]
Hardware/CCC_rig_NTC_in/Fab_outs_NTC/CCC_rig_NTC_in-NPTH-drl-drl_map.dxf
70.1 x 83.1
