OisinS13/Peltier_rig/Hardware/CCC_rig_backplane/AndersonPP45 v2.step

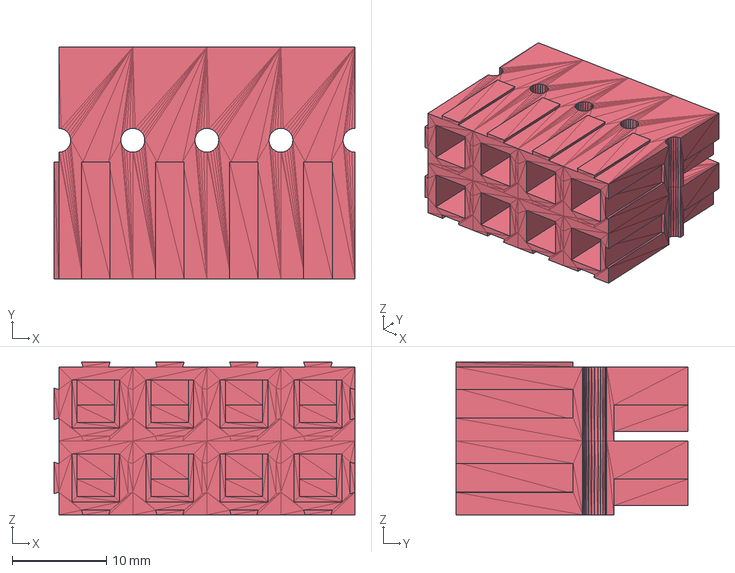
[picture p5: CAD file, 2023-10-16]
Hardware/CCC_rig_backplane/AndersonPP45 v2.step
32.0 x 24.6 x 16.3 mm
