OisinS13/Peltier_rig/Hardware/CCC_rig_NTC_in/Fab_outs_NTC/CCC_rig_NTC_in-PTH-drl-drl_map.dxf

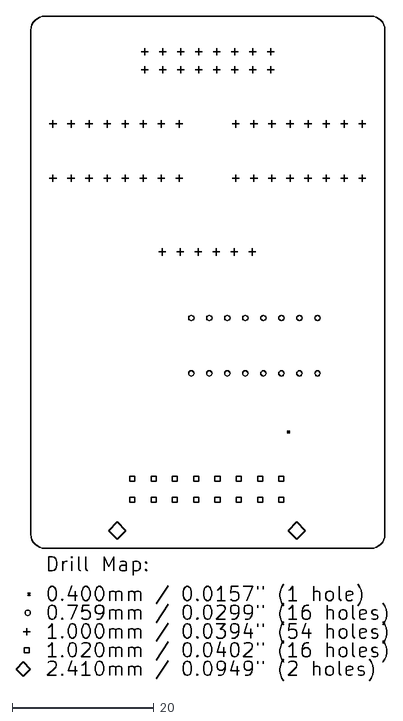
[picture p6: CAD file, 2023-10-16]
Hardware/CCC_rig_NTC_in/Fab_outs_NTC/CCC_rig_NTC_in-PTH-drl-drl_map.dxf
52.2 x 93.7
