OisinS13/Peltier_rig/(list of files, drawings)

Other design files:
Hardware/CCC_rig_backplane/CCC_rig_backplane.dsn
Hardware/CCC_rig_controller/CCC_rig_controller/CCC_rig_controller.dsn
Hardware/CCC_rig_controller/CCC_rig_controller/CCC_rig_controller_test.dsn
Hardware/CCC_rig_driver/CCC_rig_driver.dsn
Hardware/CCC_rig_NTC_in/CCC_rig_NTC_in.dsn
