OisinS13/Peltier_rig/Hardware/CCC_rig_NTC_in/CCC_rig_NTC_in.kicad_pcb

## KiCad design Hardware/CCC_rig_NTC_in/CCC_rig_NTC_in.kicad_pcb (2023-10-16)

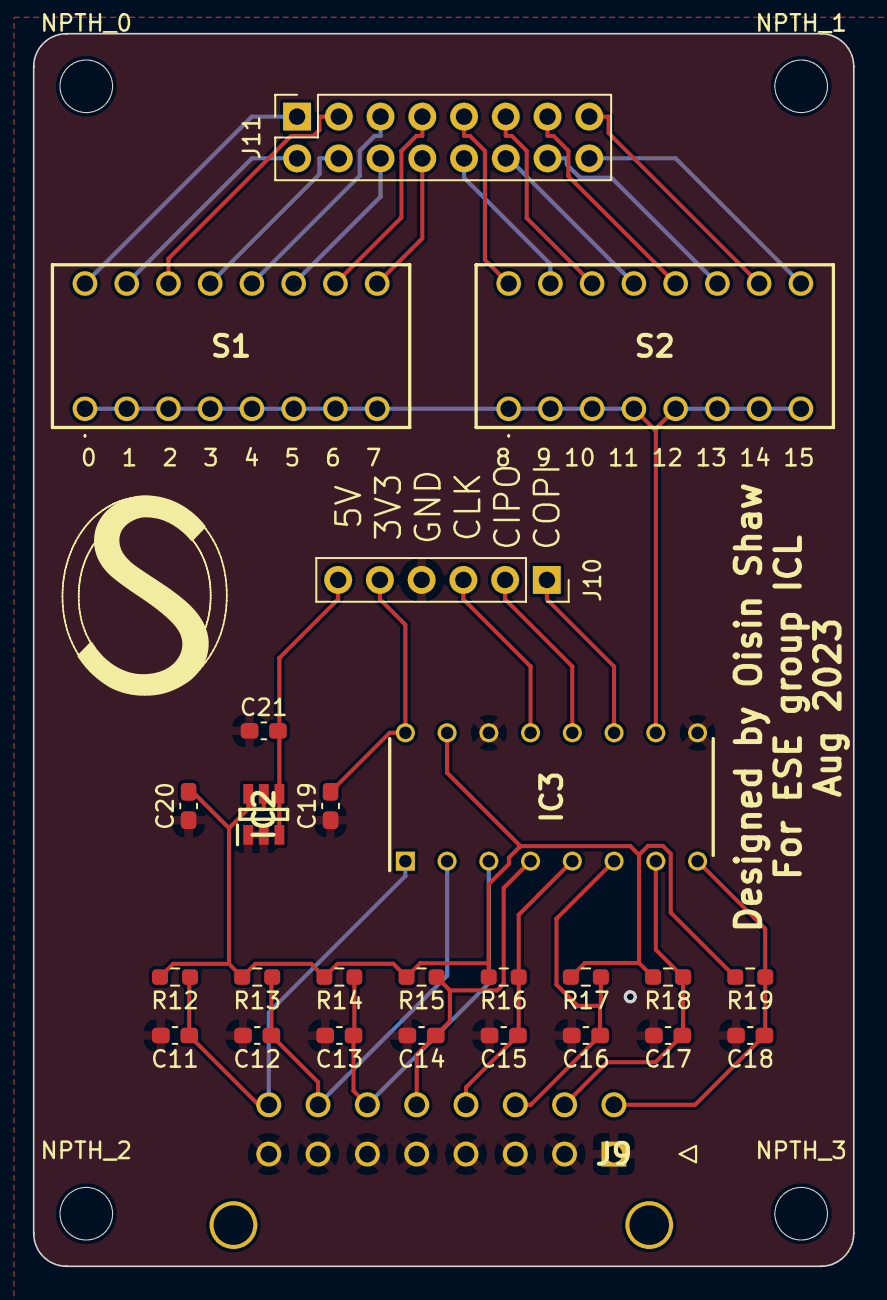
[picture p7: board CCC_rig_NTC_in.kicad_pcb from above]

Board: 2 copper layers, 49.9 x 75.0 mm, 30 parts (0 on the bottom side), 32 nets.

Parts:
C11, C12, C13, C14, C15, C16, C17, C18, C19, C20: 10 nF; C_0603_1608Metric_Pad1.08x0.95mm_HandSolder
C21: 1 uF; C_0603_1608Metric_Pad1.08x0.95mm_HandSolder
IC2: REF3433IDBVR; SOT95P280X145-6N
IC3: MCP3304-CI_P; DIP781W56P254L1918H533Q16N
J9: NTC_Conn; 43045-16YY_212223
J10: NTC_ADC_Conn; PinSocket_1x06_P2.54mm_Vertical
J11: NTC_ADC_CS_Conn; PinSocket_2x08_P2.54mm_Vertical
NPTH_0, NPTH_1, NPTH_2, NPTH_3: MountingHole_3.2mm_M3_ISO7380
R12, R13, R14, R15, R16, R17, R18, R19: 6.8k; R_0603_1608Metric_Pad0.98x0.95mm_HandSolder
S1, S2: DS01C-254-S-08BE; DS01C254S08BE

Connections:
3V3_ref_NTC_ADC: C20.2, IC2.5 (OUT_S), IC2.6 (OUT_F), IC3.15 (VREF), R12.2, R13.2, R14.2, R15.2, R16.2, R17.2, R18.2, R19.2
+3.3V: C19.2, IC3.16 (VDD), J10.5
+5V: C21.2, IC2.3 (ENABLE), IC2.4 (IN), J10.6
ADC_SPI_CLK: IC3.13 (CLK), J10.3
ADC_SPI_MISO: IC3.12 (DOUT), J10.2
ADC_SPI_MOSI: IC3.11 (DIN), J10.1
GNDD: C11.2, C12.2, C13.2, C14.2, C15.2, C16.2, C17.2, C18.2, C19.1, C20.1, C21.1, IC2.1 (GND_F), IC2.2 (GND_S), IC3.9 (DGND), IC3.14 (AGND), J9.1, J9.2, J9.3, J9.4, J9.5, J9.6, J9.7, J9.8, J10.4
NTC_ADC_CH0: C11.1, IC3.1 (CH0), J9.16, R12.1
NTC_ADC_CH1: C12.1, IC3.2 (CH1), J9.15, R13.1
NTC_ADC_CH2: C13.1, IC3.3 (CH2), J9.14, R14.1
NTC_ADC_CH3: C14.1, IC3.4 (CH3), J9.13, R15.1
NTC_ADC_CH4: C15.1, IC3.5 (CH4), J9.12, R16.1
NTC_ADC_CH5: C16.1, IC3.6 (CH5), J9.11, R17.1
NTC_ADC_CH6: C17.1, IC3.7 (CH6), J9.10, R18.1
NTC_ADC_CH7: C18.1, IC3.8 (CH7), J9.9, R19.1
NTC_ADC_CS: IC3.10 (~CS/SHDN), S1.1 (COM_1), S1.3 (COM_2), S1.5 (COM_3), S1.7 (COM_4), S1.9 (COM_5), S1.11 (COM_6), S1.13 (COM_7), S1.15 (COM_8), S2.1 (COM_1), S2.3 (COM_2), S2.5 (COM_3), S2.7 (COM_4), S2.9 (COM_5), S2.11 (COM_6), S2.13 (COM_7), S2.15 (COM_8)
NTC_ADC_CS_00: J11.1, S1.2 (NO_1)
NTC_ADC_CS_01: J11.2, S1.4 (NO_2)
NTC_ADC_CS_02: J11.3, S1.6 (NO_3)
NTC_ADC_CS_03: J11.4, S1.8 (NO_4)
NTC_ADC_CS_04: J11.5, S1.10 (NO_5)
NTC_ADC_CS_05: J11.6, S1.12 (NO_6)
NTC_ADC_CS_06: J11.7, S1.14 (NO_7)
NTC_ADC_CS_07: J11.8, S1.16 (NO_8)
NTC_ADC_CS_08: J11.9, S2.2 (NO_1)
NTC_ADC_CS_09: J11.10, S2.4 (NO_2)
NTC_ADC_CS_10: J11.11, S2.6 (NO_3)
NTC_ADC_CS_11: J11.12, S2.8 (NO_4)
NTC_ADC_CS_12: J11.13, S2.10 (NO_5)
NTC_ADC_CS_13: J11.14, S2.12 (NO_6)
NTC_ADC_CS_14: J11.15, S2.14 (NO_7)
NTC_ADC_CS_15: J11.16, S2.16 (NO_8)
