OisinS13/Peltier_rig/Hardware/CCC_rig_driver/CCC_rig_driver.kicad_pcb

## KiCad design Hardware/CCC_rig_driver/CCC_rig_driver.kicad_pcb (2023-10-16)

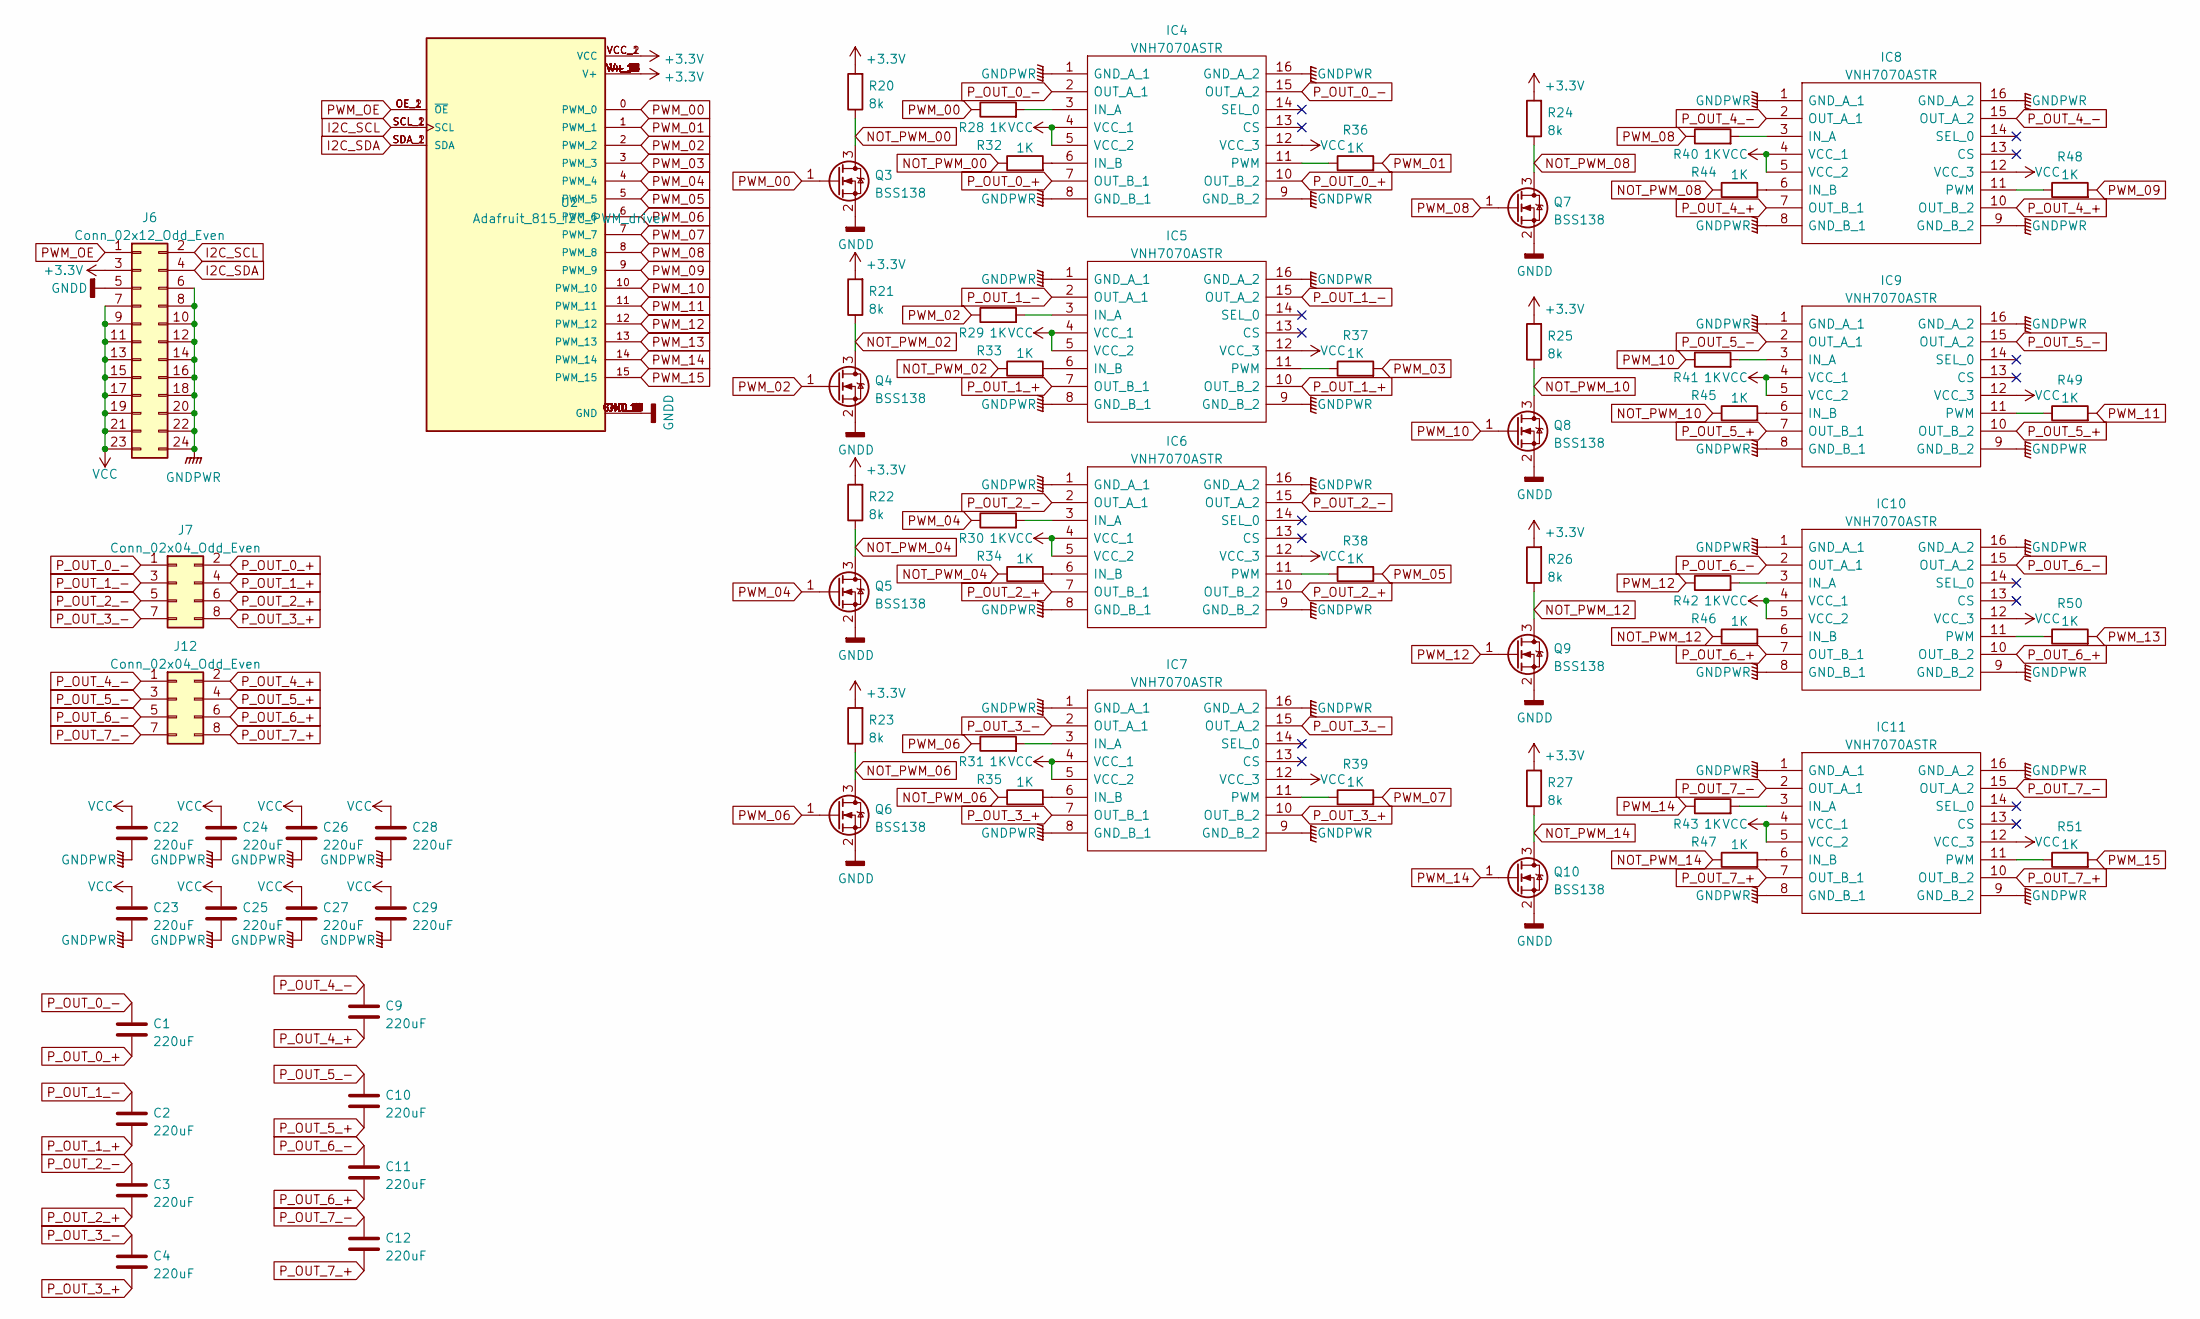
[picture p8: schematic CCC_rig_driver.kicad_sch]

Parts:
C1, C2, C3, C4, C9, C10, C11, C12: 220uF; CP_Radial_D5.0mm_P2.50mm
C22, C23, C24, C25, C26, C27, C28, C29: 220uF; CP_Radial_D8.0mm_P3.50mm
IC4, IC5, IC6, IC7, IC8, IC9, IC10, IC11: VNH7070ASTR; SOIC127P600X175-16N-layout; Mouser Part Number 511-VNH7070ASTR
J6: Conn_02x12_Odd_Even; TE-5530843-1-2x12_edge_connector
J7, J12: Conn_02x04_Odd_Even; Anderson_PCB_mount_P1545_2x4
Q3, Q4, Q5, Q6, Q7, Q8, Q9, Q10: BSS138; SOT-23
R20, R21, R22, R23, R24, R25, R26, R27: 8k; R_0603_1608Metric_Pad0.98x0.95mm_HandSolder
R28, R29, R30, R31, R32, R33, R34, R35, R36, R37, R38, R39, R40, R41, R42, R43, R44, R45, R46, R47, R48, R49, R50, R51: 1K; R_0603_1608Metric_Pad0.98x0.95mm_HandSolder
U2: Adafruit_815_I2C_PWM_driver; MODULE_815

Connections:
+3.3V: J6.3, R20.2, R21.2, R22.2, R23.2, R24.2, R25.2, R26.2, R27.2, U2.V+_1 (V+), U2.V+_2 (V+), U2.V+_3 (V+), U2.V+_4 (V+), U2.V+_5 (V+), U2.V+_6 (V+), U2.V+_7 (V+), U2.V+_8 (V+), U2.V+_9 (V+), U2.V+_10 (V+), U2.V+_11 (V+), U2.V+_12 (V+), U2.V+_13 (V+), U2.V+_14 (V+), U2.V+_15 (V+), U2.V+_16 (V+), U2.V+_17 (V+), U2.V+_18 (V+), U2.VCC_1 (VCC), U2.VCC_2 (VCC)
GNDD: J6.5, Q3.2 (S), Q4.2 (S), Q5.2 (S), Q6.2 (S), Q7.2 (S), Q8.2 (S), Q9.2 (S), Q10.2 (S), U2.GND_1 (GND), U2.GND_2 (GND), U2.GND_3 (GND), U2.GND_4 (GND), U2.GND_5 (GND), U2.GND_6 (GND), U2.GND_7 (GND), U2.GND_8 (GND), U2.GND_9 (GND), U2.GND_10 (GND), U2.GND_11 (GND), U2.GND_12 (GND), U2.GND_13 (GND), U2.GND_14 (GND), U2.GND_15 (GND), U2.GND_16 (GND), U2.GND_17 (GND), U2.GND_18 (GND)
GNDPWR: C22.2, C23.2, C24.2, C25.2, C26.2, C27.2, C28.2, C29.2, IC4.1 (GND_A_1), IC4.8 (GND_B_1), IC4.9 (GND_B_2), IC4.16 (GND_A_2), IC5.1 (GND_A_1), IC5.8 (GND_B_1), IC5.9 (GND_B_2), IC5.16 (GND_A_2), IC6.1 (GND_A_1), IC6.8 (GND_B_1), IC6.9 (GND_B_2), IC6.16 (GND_A_2), IC7.1 (GND_A_1), IC7.8 (GND_B_1), IC7.9 (GND_B_2), IC7.16 (GND_A_2), IC8.1 (GND_A_1), IC8.8 (GND_B_1), IC8.9 (GND_B_2), IC8.16 (GND_A_2), IC9.1 (GND_A_1), IC9.8 (GND_B_1), IC9.9 (GND_B_2), IC9.16 (GND_A_2), IC10.1 (GND_A_1), IC10.8 (GND_B_1), IC10.9 (GND_B_2), IC10.16 (GND_A_2), IC11.1 (GND_A_1), IC11.8 (GND_B_1), IC11.9 (GND_B_2), IC11.16 (GND_A_2), J6.6, J6.8, J6.10, J6.12, J6.14, J6.16, J6.18, J6.20, J6.22, J6.24
I2C_SCL: J6.2, U2.SCL_1 (SCL), U2.SCL_2 (SCL)
I2C_SDA: J6.4, U2.SDA_1 (SDA), U2.SDA_2 (SDA)
NOT_PWM_00: Q3.3 (D), R20.1, R32.1
NOT_PWM_02: Q4.3 (D), R21.1, R33.1
NOT_PWM_04: Q5.3 (D), R22.1, R34.1
NOT_PWM_06: Q6.3 (D), R23.1, R35.1
NOT_PWM_08: Q7.3 (D), R24.1, R44.1
NOT_PWM_10: Q8.3 (D), R25.1, R45.1
NOT_PWM_12: Q9.3 (D), R26.1, R46.1
NOT_PWM_14: Q10.3 (D), R27.1, R47.1
unnamed: IC4.3 (IN_A), R28.2
unnamed: IC4.6 (IN_B), R32.2
unnamed: IC4.11 (PWM), R36.1
unnamed: IC5.3 (IN_A), R29.2
unnamed: IC5.6 (IN_B), R33.2
unnamed: IC5.11 (PWM), R37.1
unnamed: IC6.3 (IN_A), R30.2
unnamed: IC6.6 (IN_B), R34.2
unnamed: IC6.11 (PWM), R38.1
unnamed: IC7.3 (IN_A), R31.2
unnamed: IC7.6 (IN_B), R35.2
unnamed: IC7.11 (PWM), R39.1
unnamed: IC8.3 (IN_A), R40.2
unnamed: IC8.6 (IN_B), R44.2
unnamed: IC8.11 (PWM), R48.1
unnamed: IC9.3 (IN_A), R41.2
unnamed: IC9.6 (IN_B), R45.2
unnamed: IC9.11 (PWM), R49.1
unnamed: IC10.3 (IN_A), R42.2
unnamed: IC10.6 (IN_B), R46.2
unnamed: IC10.11 (PWM), R50.1
unnamed: IC11.3 (IN_A), R43.2
unnamed: IC11.6 (IN_B), R47.2
unnamed: IC11.11 (PWM), R51.1
PWM_00: Q3.1 (G), R28.1, U2.0 (PWM_0)
PWM_01: R36.2, U2.1 (PWM_1)
PWM_02: Q4.1 (G), R29.1, U2.2 (PWM_2)
PWM_03: R37.2, U2.3 (PWM_3)
PWM_04: Q5.1 (G), R30.1, U2.4 (PWM_4)
PWM_05: R38.2, U2.5 (PWM_5)
PWM_06: Q6.1 (G), R31.1, U2.6 (PWM_6)
PWM_07: R39.2, U2.7 (PWM_7)
PWM_08: Q7.1 (G), R40.1, U2.8 (PWM_8)
PWM_09: R48.2, U2.9 (PWM_9)
PWM_10: Q8.1 (G), R41.1, U2.10 (PWM_10)
PWM_11: R49.2, U2.11 (PWM_11)
PWM_12: Q9.1 (G), R42.1, U2.12 (PWM_12)
PWM_13: R50.2, U2.13 (PWM_13)
PWM_14: Q10.1 (G), R43.1, U2.14 (PWM_14)
PWM_15: R51.2, U2.15 (PWM_15)
PWM_OE: J6.1, U2.OE_1 (~OE), U2.OE_2 (~OE)
P_OUT_0_+: C1.2, IC4.7 (OUT_B_1), IC4.10 (OUT_B_2), J7.2
P_OUT_0_-: C1.1, IC4.2 (OUT_A_1), IC4.15 (OUT_A_2), J7.1
P_OUT_1_+: C2.2, IC5.7 (OUT_B_1), IC5.10 (OUT_B_2), J7.4
P_OUT_1_-: C2.1, IC5.2 (OUT_A_1), IC5.15 (OUT_A_2), J7.3
P_OUT_2_+: C3.2, IC6.7 (OUT_B_1), IC6.10 (OUT_B_2), J7.6
P_OUT_2_-: C3.1, IC6.2 (OUT_A_1), IC6.15 (OUT_A_2), J7.5
P_OUT_3_+: C4.2, IC7.7 (OUT_B_1), IC7.10 (OUT_B_2), J7.8
P_OUT_3_-: C4.1, IC7.2 (OUT_A_1), IC7.15 (OUT_A_2), J7.7
P_OUT_4_+: C9.2, IC8.7 (OUT_B_1), IC8.10 (OUT_B_2), J12.2
P_OUT_4_-: C9.1, IC8.2 (OUT_A_1), IC8.15 (OUT_A_2), J12.1
P_OUT_5_+: C10.2, IC9.7 (OUT_B_1), IC9.10 (OUT_B_2), J12.4
P_OUT_5_-: C10.1, IC9.2 (OUT_A_1), IC9.15 (OUT_A_2), J12.3
P_OUT_6_+: C11.2, IC10.7 (OUT_B_1), IC10.10 (OUT_B_2), J12.6
P_OUT_6_-: C11.1, IC10.2 (OUT_A_1), IC10.15 (OUT_A_2), J12.5
P_OUT_7_+: C12.2, IC11.7 (OUT_B_1), IC11.10 (OUT_B_2), J12.8
P_OUT_7_-: C12.1, IC11.2 (OUT_A_1), IC11.15 (OUT_A_2), J12.7
VCC: C22.1, C23.1, C24.1, C25.1, C26.1, C27.1, C28.1, C29.1, IC4.4 (VCC_1), IC4.5 (VCC_2), IC4.12 (VCC_3), IC5.4 (VCC_1), IC5.5 (VCC_2), IC5.12 (VCC_3), IC6.4 (VCC_1), IC6.5 (VCC_2), IC6.12 (VCC_3), IC7.4 (VCC_1), IC7.5 (VCC_2), IC7.12 (VCC_3), IC8.4 (VCC_1), IC8.5 (VCC_2), IC8.12 (VCC_3), IC9.4 (VCC_1), IC9.5 (VCC_2), IC9.12 (VCC_3), IC10.4 (VCC_1), IC10.5 (VCC_2), IC10.12 (VCC_3), IC11.4 (VCC_1), IC11.5 (VCC_2), IC11.12 (VCC_3), J6.7, J6.9, J6.11, J6.13, J6.15, J6.17, J6.19, J6.21, J6.23

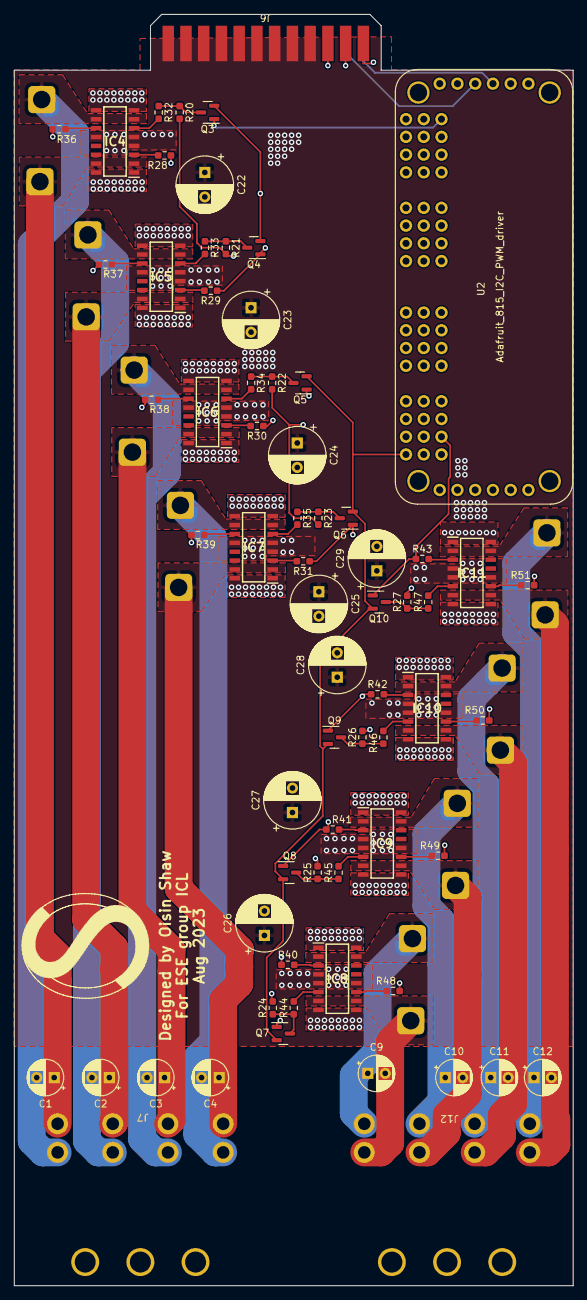
[picture p9: board CCC_rig_driver.kicad_pcb from above]

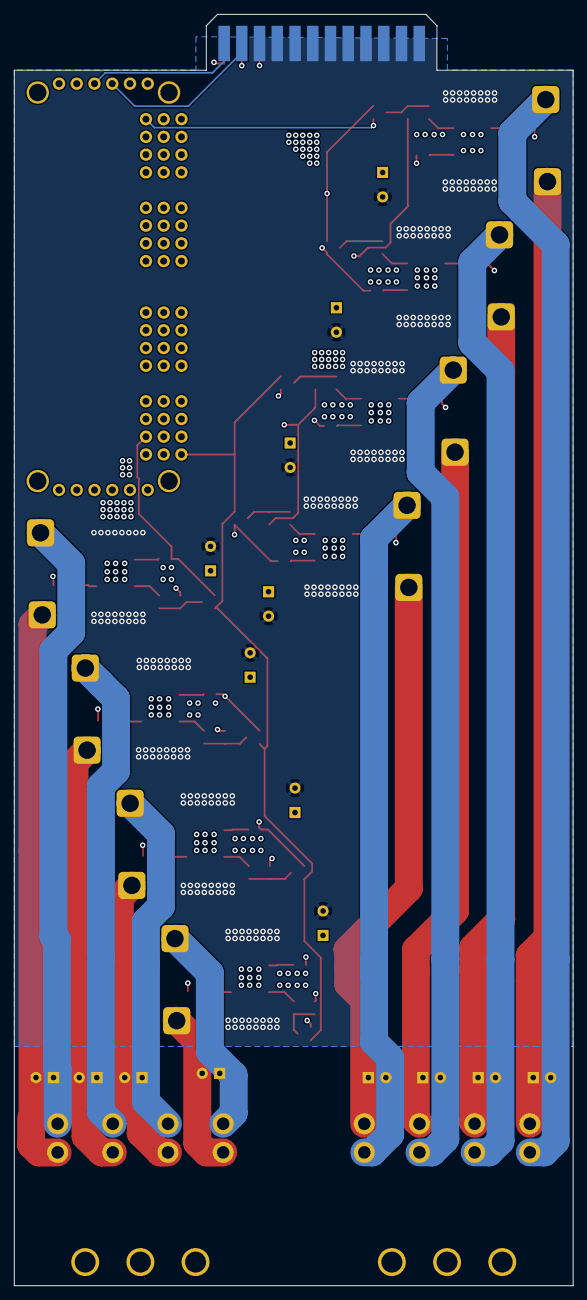
[picture p10: board CCC_rig_driver.kicad_pcb from below]

Board: 4 copper layers, 80.0 x 182.0 mm, 68 parts (2 on the bottom side), 71 nets.
