OisinS13/Peltier_rig/Hardware/CCC_rig_controller/CCC_rig_controller/CCC_rig_controller.kicad_pcb

## KiCad design Hardware/CCC_rig_controller/CCC_rig_controller/CCC_rig_controller.kicad_pcb (2023-10-16)

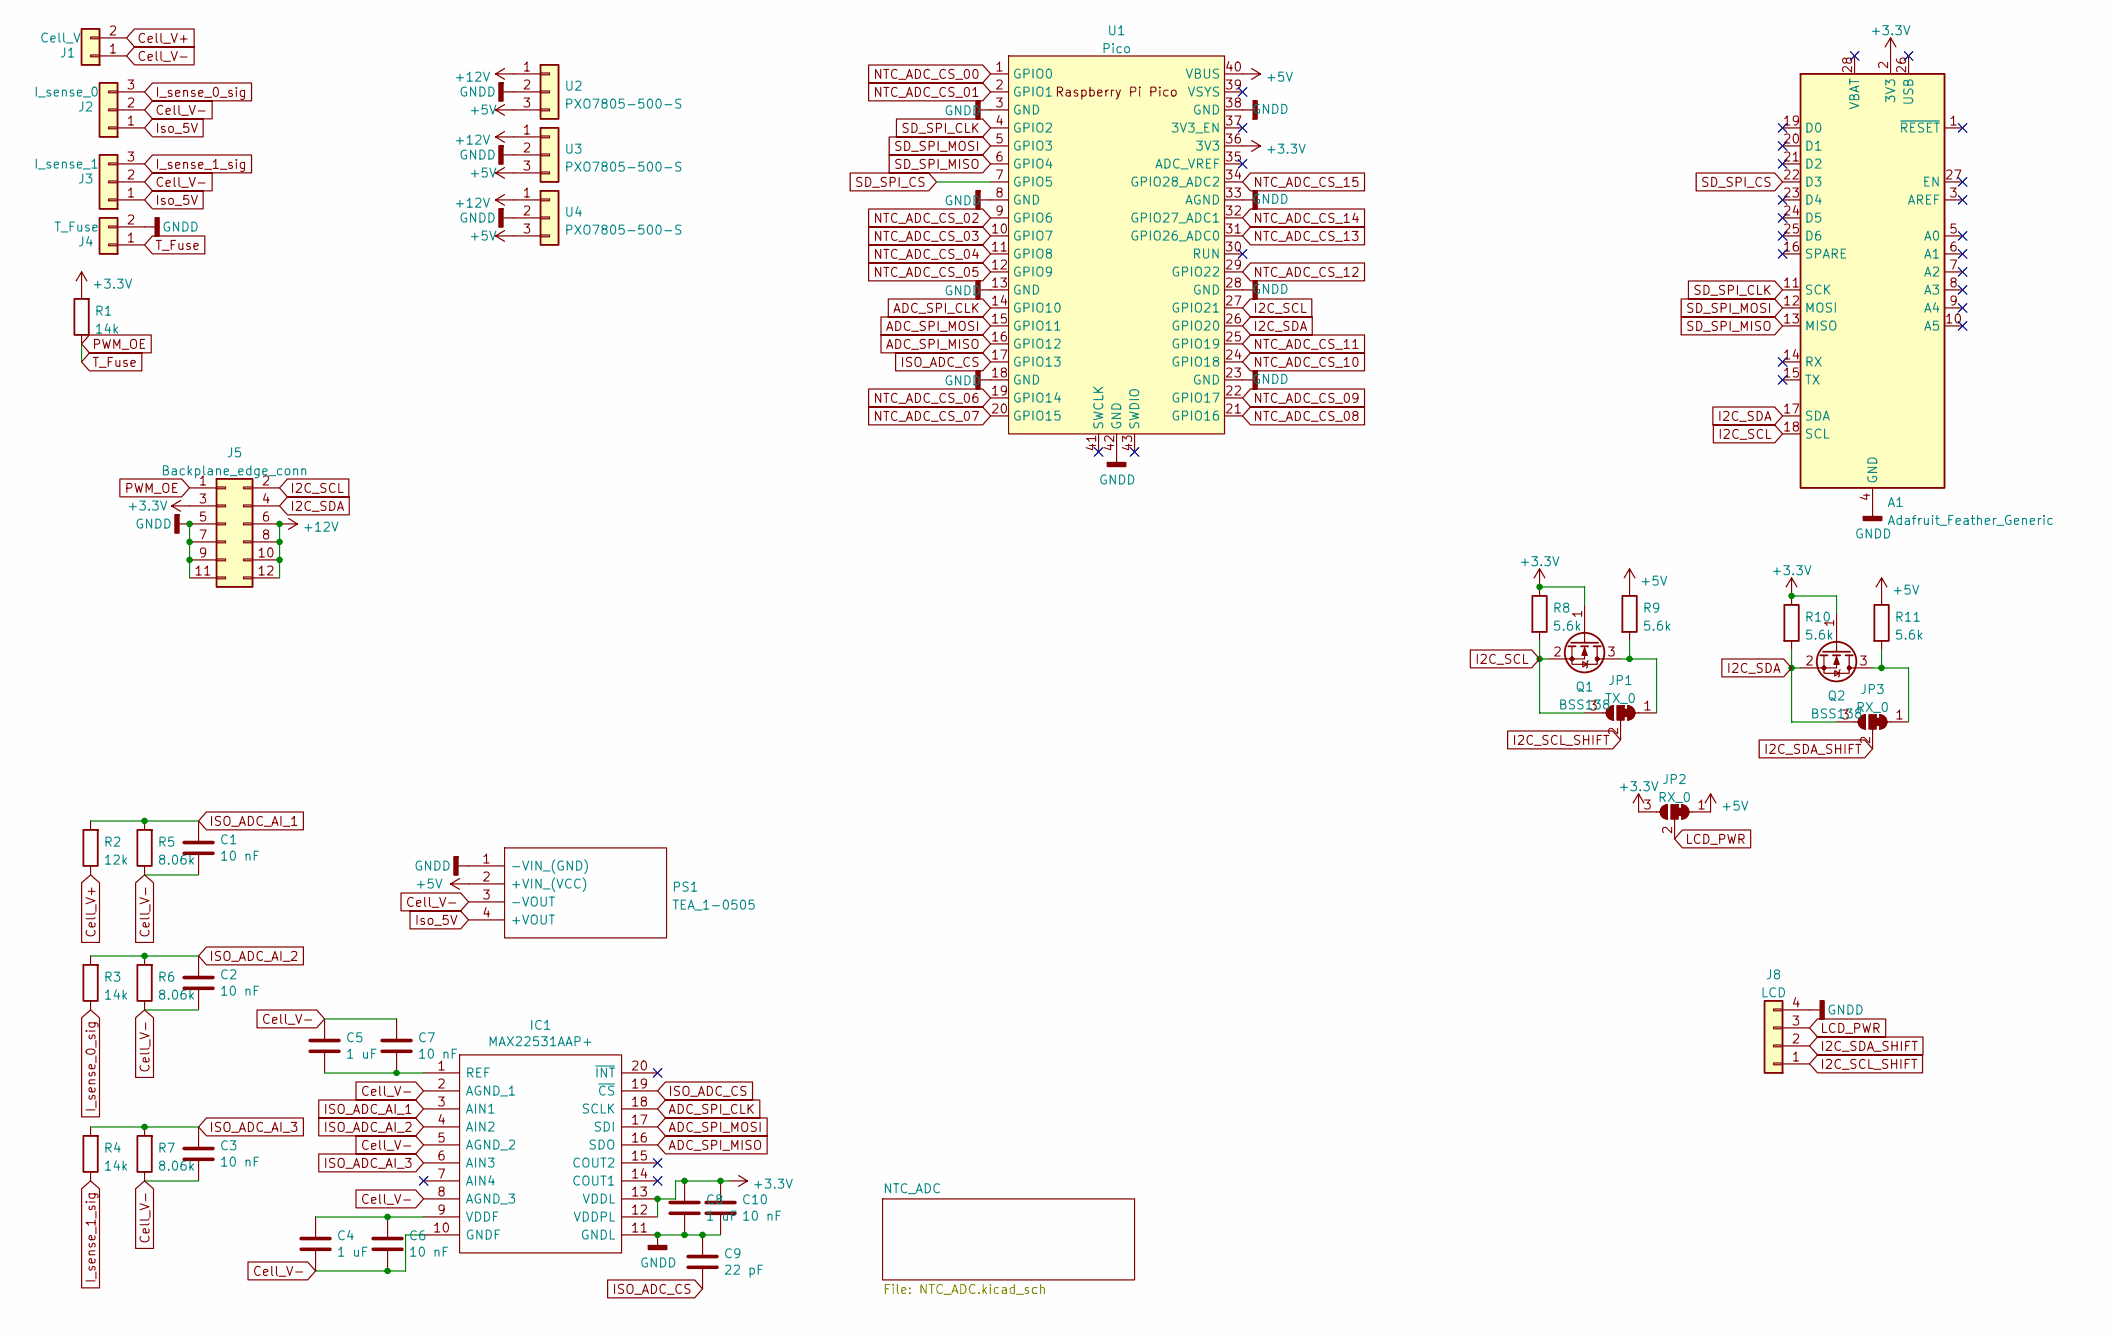
[picture p11: schematic CCC_rig_controller.kicad_sch]

Parts:
A1: Adafruit_Feather_Generic; Adafruit_Feather
C1, C2, C3, C6, C7, C10: 10 nF; C_0603_1608Metric_Pad1.08x0.95mm_HandSolder
C4, C5, C8: 1 uF; C_0603_1608Metric_Pad1.08x0.95mm_HandSolder
C9: 22 pF; C_0603_1608Metric_Pad1.08x0.95mm_HandSolder
IC1: MAX22531AAP+; SOP65P778X199-20N; Mouser Part Number 700-MAX22531AAP+
J1: Cell_V; 1963531
J2: I_sense_0; 1963544
J3: I_sense_1; 1963544
J4: T_Fuse; 1963531
J5: Backplane_edge_conn; TE-7-5530843-5-2x6_edge_connector
J8: LCD; 1963557
JP1: TX_0; SolderJumper-3_P1.3mm_Bridged2Bar12_RoundedPad1.0x1.5mm
JP2, JP3: RX_0; SolderJumper-3_P1.3mm_Bridged2Bar12_RoundedPad1.0x1.5mm
PS1: TEA_1-0505; TEA10505; Mouser Part Number 495-TEA1-0505
Q1, Q2: BSS138; SOT-23
R1, R3, R4: 14k; R_0603_1608Metric_Pad0.98x0.95mm_HandSolder
R2: 12k; R_0603_1608Metric_Pad0.98x0.95mm_HandSolder
R5, R6, R7: 8.06k; R_0603_1608Metric_Pad0.98x0.95mm_HandSolder
R8, R9, R10, R11: 5.6k; R_0603_1608Metric_Pad0.98x0.95mm_HandSolder
U1: Pico; RPi_Pico_SMD_TH
U2, U3, U4: PXO7805-500-S

Connections:
+3.3V: A1.2 (3V3), C8.1, C10.1, IC1.12 (VDDPL), IC1.13 (VDDL), J5.3, JP2.3 (B), Q1.1 (G), Q2.1 (G), R1.2, R8.1, R10.1, U1.36 (3V3); also elsewhere on the board
+5V: JP2.1 (A), PS1.2 (+VIN_(VCC)), R9.1, R11.1, U1.40 (VBUS), U2.3, U3.3, U4.3; also elsewhere on the board
+12V: J5.6, J5.8, J5.10, J5.12, U2.1, U3.1, U4.1
ADC_SPI_CLK: IC1.18 (SCLK), U1.14 (GPIO10)
ADC_SPI_MISO: IC1.16 (SDO), U1.16 (GPIO12)
ADC_SPI_MOSI: IC1.17 (SDI), U1.15 (GPIO11)
Cell_V+: J1.2, R2.1
Cell_V-: C1.2, C2.2, C3.2, C4.2, C5.1, C6.2, C7.1, IC1.2 (AGND_1), IC1.5 (AGND_2), IC1.8 (AGND_3), IC1.10 (GNDF), J1.1, J2.2, J3.2, PS1.3 (-VOUT), R5.1, R6.1, R7.1
GNDD: A1.4 (GND), C8.2, C9.1, C10.2, IC1.11 (GNDL), J4.2, J5.5, J5.7, J5.9, J5.11, J8.4, PS1.1 (-VIN_(GND)), U1.3 (GND), U1.8 (GND), U1.13 (GND), U1.18 (GND), U1.23 (GND), U1.28 (GND), U1.33 (AGND), U1.38 (GND), U1.42 (GND), U2.2, U3.2, U4.2; also elsewhere on the board
I2C_SCL: A1.18 (SCL), J5.2, JP1.3 (B), Q1.2 (S), R8.2, U1.27 (GPIO21)
I2C_SCL_SHIFT: J8.1, JP1.2 (C)
I2C_SDA: A1.17 (SDA), J5.4, JP3.3 (B), Q2.2 (S), R10.2, U1.26 (GPIO20)
I2C_SDA_SHIFT: J8.2, JP3.2 (C)
ISO_ADC_AI_1: C1.1, IC1.3 (AIN1), R2.2, R5.2
ISO_ADC_AI_2: C2.1, IC1.4 (AIN2), R3.2, R6.2
ISO_ADC_AI_3: C3.1, IC1.6 (AIN3), R4.2, R7.2
ISO_ADC_CS: C9.2, IC1.19 (~CS), U1.17 (GPIO13)
I_sense_0_sig: J2.3, R3.1
I_sense_1_sig: J3.3, R4.1
Iso_5V: J2.1, J3.1, PS1.4 (+VOUT)
LCD_PWR: J8.3, JP2.2 (C)
NTC_ADC_CS_00: U1.1 (GPIO0); also elsewhere on the board
NTC_ADC_CS_01: U1.2 (GPIO1); also elsewhere on the board
NTC_ADC_CS_02: U1.9 (GPIO6); also elsewhere on the board
NTC_ADC_CS_03: U1.10 (GPIO7); also elsewhere on the board
NTC_ADC_CS_04: U1.11 (GPIO8); also elsewhere on the board
NTC_ADC_CS_05: U1.12 (GPIO9); also elsewhere on the board
NTC_ADC_CS_06: U1.19 (GPIO14); also elsewhere on the board
NTC_ADC_CS_07: U1.20 (GPIO15); also elsewhere on the board
NTC_ADC_CS_08: U1.21 (GPIO16); also elsewhere on the board
NTC_ADC_CS_09: U1.22 (GPIO17); also elsewhere on the board
NTC_ADC_CS_10: U1.24 (GPIO18); also elsewhere on the board
NTC_ADC_CS_11: U1.25 (GPIO19); also elsewhere on the board
NTC_ADC_CS_12: U1.29 (GPIO22); also elsewhere on the board
NTC_ADC_CS_13: U1.31 (GPIO26_ADC0); also elsewhere on the board
NTC_ADC_CS_14: U1.32 (GPIO27_ADC1); also elsewhere on the board
NTC_ADC_CS_15: U1.34 (GPIO28_ADC2); also elsewhere on the board
unnamed: C4.1, C6.1, IC1.9 (VDDF)
unnamed: C5.2, C7.2, IC1.1 (REF)
unnamed: JP1.1 (A), Q1.3 (D), R9.2
unnamed: JP3.1 (A), Q2.3 (D), R11.2
PWM_OE: J4.1, J5.1, R1.1
SD_SPI_CLK: A1.11 (SCK), U1.4 (GPIO2); also elsewhere on the board
SD_SPI_CS: A1.22 (D3), U1.7 (GPIO5)
SD_SPI_MISO: A1.13 (MISO), U1.6 (GPIO4); also elsewhere on the board
SD_SPI_MOSI: A1.12 (MOSI), U1.5 (GPIO3); also elsewhere on the board

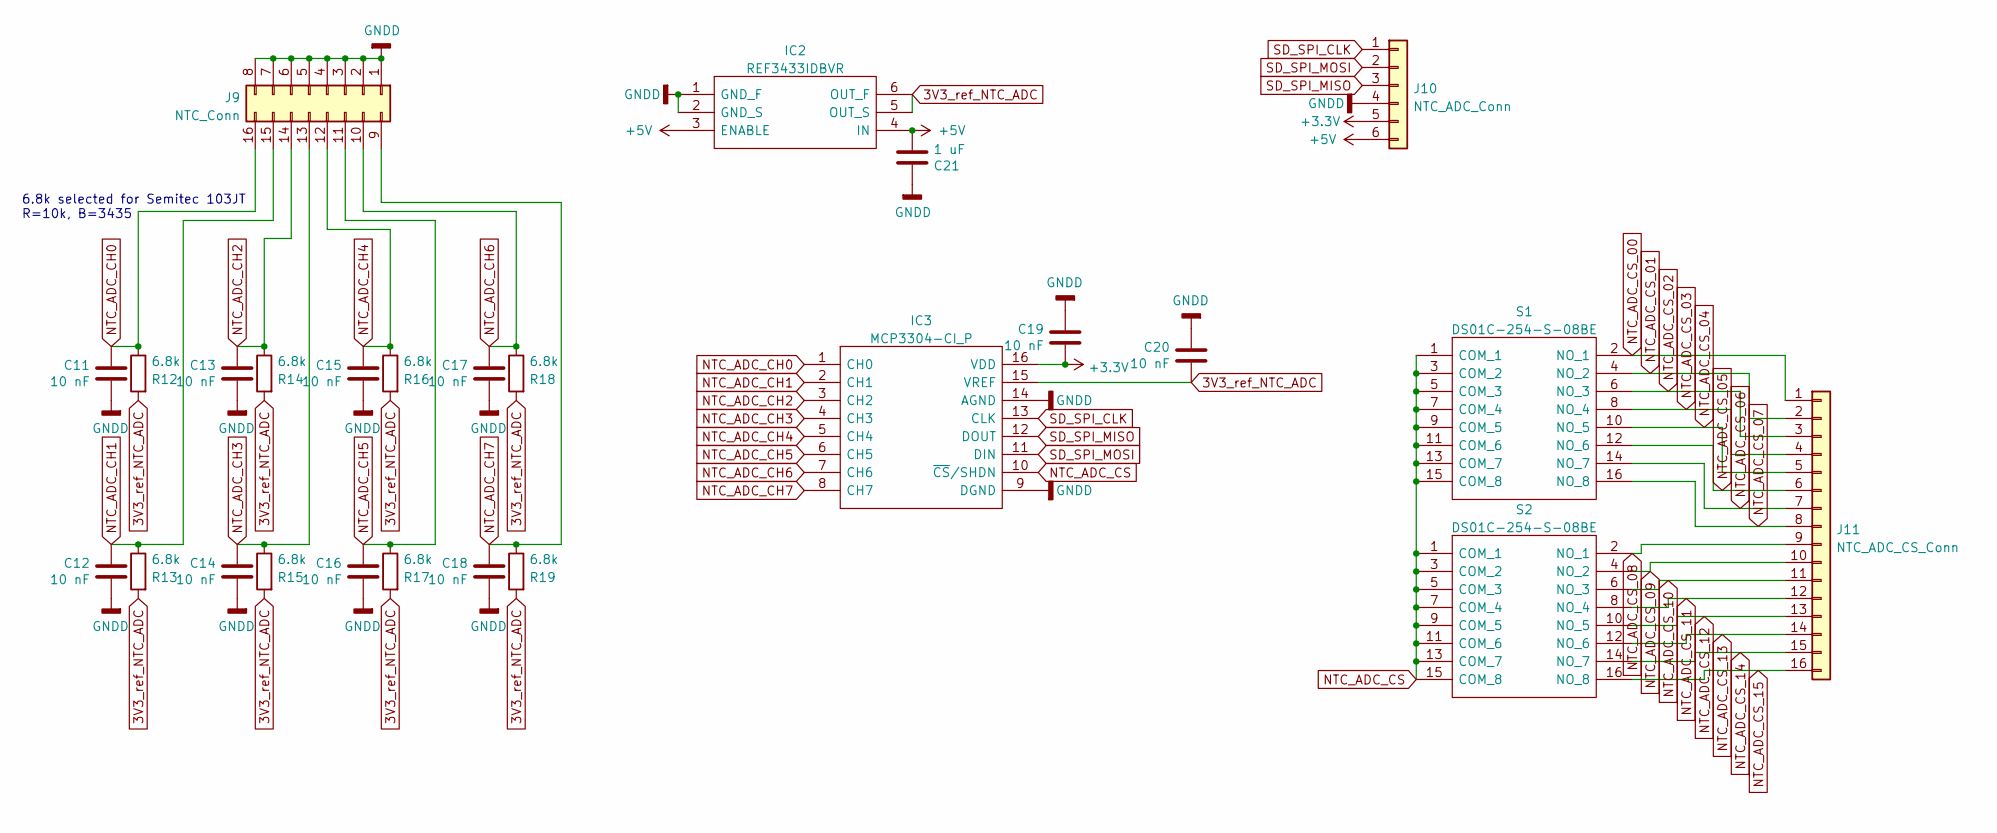
[picture p12: schematic NTC_ADC.kicad_sch]

Parts:
C11, C12, C13, C14, C15, C16, C17, C18, C19, C20: 10 nF; C_0603_1608Metric_Pad1.08x0.95mm_HandSolder
C21: 1 uF; C_0603_1608Metric_Pad1.08x0.95mm_HandSolder
IC2: REF3433IDBVR; SOT95P280X145-6N; Mouser Part Number 595-REF3433IDBVR
IC3: MCP3304-CI_P; DIP781W56P254L1918H533Q16N; Mouser Part Number 579-MCP3304-CI/P
J9: NTC_Conn; 43045-16YY_212223
J10: NTC_ADC_Conn; PinSocket_1x06_P2.54mm_Vertical
J11: NTC_ADC_CS_Conn; PinSocket_2x08_P2.54mm_Vertical
R12, R13, R14, R15, R16, R17, R18, R19: 6.8k; R_0603_1608Metric_Pad0.98x0.95mm_HandSolder
S1, S2: DS01C-254-S-08BE; DS01C254S08BE; Mouser Part Number 490-DS01C-254-S-08BE

Connections:
3V3_ref_NTC_ADC: C20.2, IC2.5 (OUT_S), IC2.6 (OUT_F), IC3.15 (VREF), R12.2, R13.2, R14.2, R15.2, R16.2, R17.2, R18.2, R19.2
+3.3V: C19.2, IC3.16 (VDD), J10.5; also elsewhere on the board
+5V: C21.2, IC2.3 (ENABLE), IC2.4 (IN), J10.6; also elsewhere on the board
GNDD: C11.2, C12.2, C13.2, C14.2, C15.2, C16.2, C17.2, C18.2, C19.1, C20.1, C21.1, IC2.1 (GND_F), IC2.2 (GND_S), IC3.9 (DGND), IC3.14 (AGND), J9.1, J9.2, J9.3, J9.4, J9.5, J9.6, J9.7, J9.8, J10.4; also elsewhere on the board
NTC_ADC_CH0: C11.1, IC3.1 (CH0), J9.16, R12.1
NTC_ADC_CH1: C12.1, IC3.2 (CH1), J9.15, R13.1
NTC_ADC_CH2: C13.1, IC3.3 (CH2), J9.14, R14.1
NTC_ADC_CH3: C14.1, IC3.4 (CH3), J9.13, R15.1
NTC_ADC_CH4: C15.1, IC3.5 (CH4), J9.12, R16.1
NTC_ADC_CH5: C16.1, IC3.6 (CH5), J9.11, R17.1
NTC_ADC_CH6: C17.1, IC3.7 (CH6), J9.10, R18.1
NTC_ADC_CH7: C18.1, IC3.8 (CH7), J9.9, R19.1
NTC_ADC_CS: IC3.10 (~CS/SHDN), S1.1 (COM_1), S1.3 (COM_2), S1.5 (COM_3), S1.7 (COM_4), S1.9 (COM_5), S1.11 (COM_6), S1.13 (COM_7), S1.15 (COM_8), S2.1 (COM_1), S2.3 (COM_2), S2.5 (COM_3), S2.7 (COM_4), S2.9 (COM_5), S2.11 (COM_6), S2.13 (COM_7), S2.15 (COM_8)
NTC_ADC_CS_00: J11.1, S1.2 (NO_1); also elsewhere on the board
NTC_ADC_CS_01: J11.2, S1.4 (NO_2); also elsewhere on the board
NTC_ADC_CS_02: J11.3, S1.6 (NO_3); also elsewhere on the board
NTC_ADC_CS_03: J11.4, S1.8 (NO_4); also elsewhere on the board
NTC_ADC_CS_04: J11.5, S1.10 (NO_5); also elsewhere on the board
NTC_ADC_CS_05: J11.6, S1.12 (NO_6); also elsewhere on the board
NTC_ADC_CS_06: J11.7, S1.14 (NO_7); also elsewhere on the board
NTC_ADC_CS_07: J11.8, S1.16 (NO_8); also elsewhere on the board
NTC_ADC_CS_08: J11.9, S2.2 (NO_1); also elsewhere on the board
NTC_ADC_CS_09: J11.10, S2.4 (NO_2); also elsewhere on the board
NTC_ADC_CS_10: J11.11, S2.6 (NO_3); also elsewhere on the board
NTC_ADC_CS_11: J11.12, S2.8 (NO_4); also elsewhere on the board
NTC_ADC_CS_12: J11.13, S2.10 (NO_5); also elsewhere on the board
NTC_ADC_CS_13: J11.14, S2.12 (NO_6); also elsewhere on the board
NTC_ADC_CS_14: J11.15, S2.14 (NO_7); also elsewhere on the board
NTC_ADC_CS_15: J11.16, S2.16 (NO_8); also elsewhere on the board
SD_SPI_CLK: IC3.13 (CLK), J10.1; also elsewhere on the board
SD_SPI_MISO: IC3.12 (DOUT), J10.3; also elsewhere on the board
SD_SPI_MOSI: IC3.11 (DIN), J10.2; also elsewhere on the board

Notes on the sheet:
6.8k selected for Semitec 103JT R=10k, B=3435

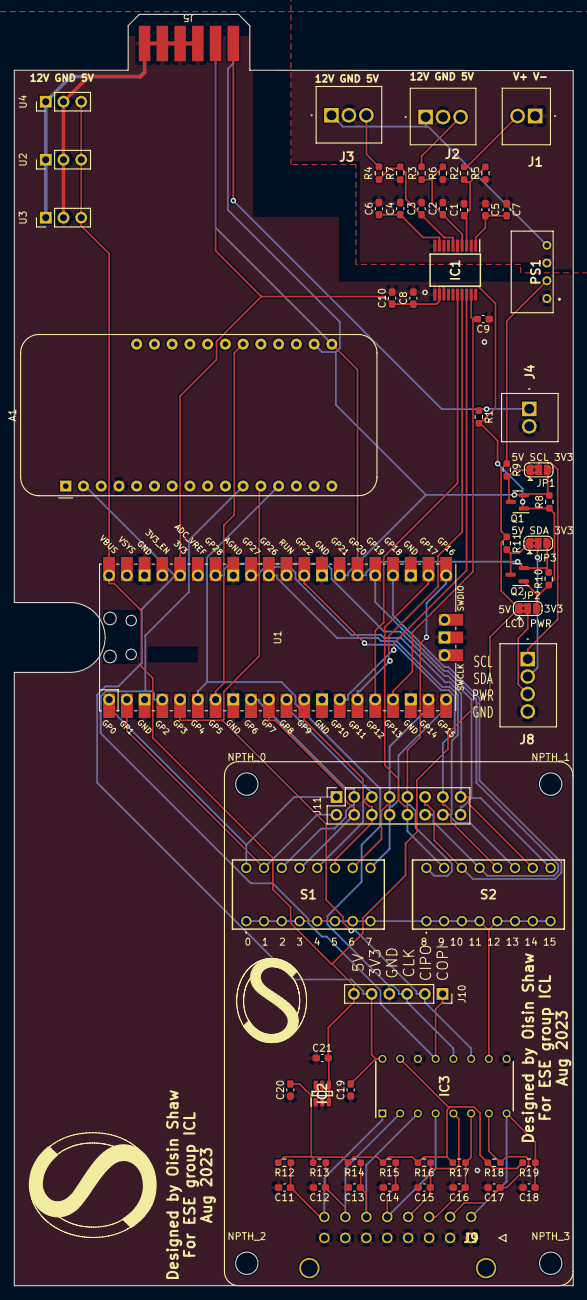
[picture p13: board CCC_rig_controller.kicad_pcb from above]

Board: 2 copper layers, 80.0 x 182.0 mm, 69 parts (0 on the bottom side), 56 nets.

Other parts of the board:
NPTH_0, NPTH_1, NPTH_2, NPTH_3: MountingHole_3.2mm_M3_ISO7380
