OisinS13/Peltier_rig/Hardware/CCC_rig_backplane/CCC_rig_backplane.kicad_pcb

## KiCad design Hardware/CCC_rig_backplane/CCC_rig_backplane.kicad_pcb (2023-10-16)

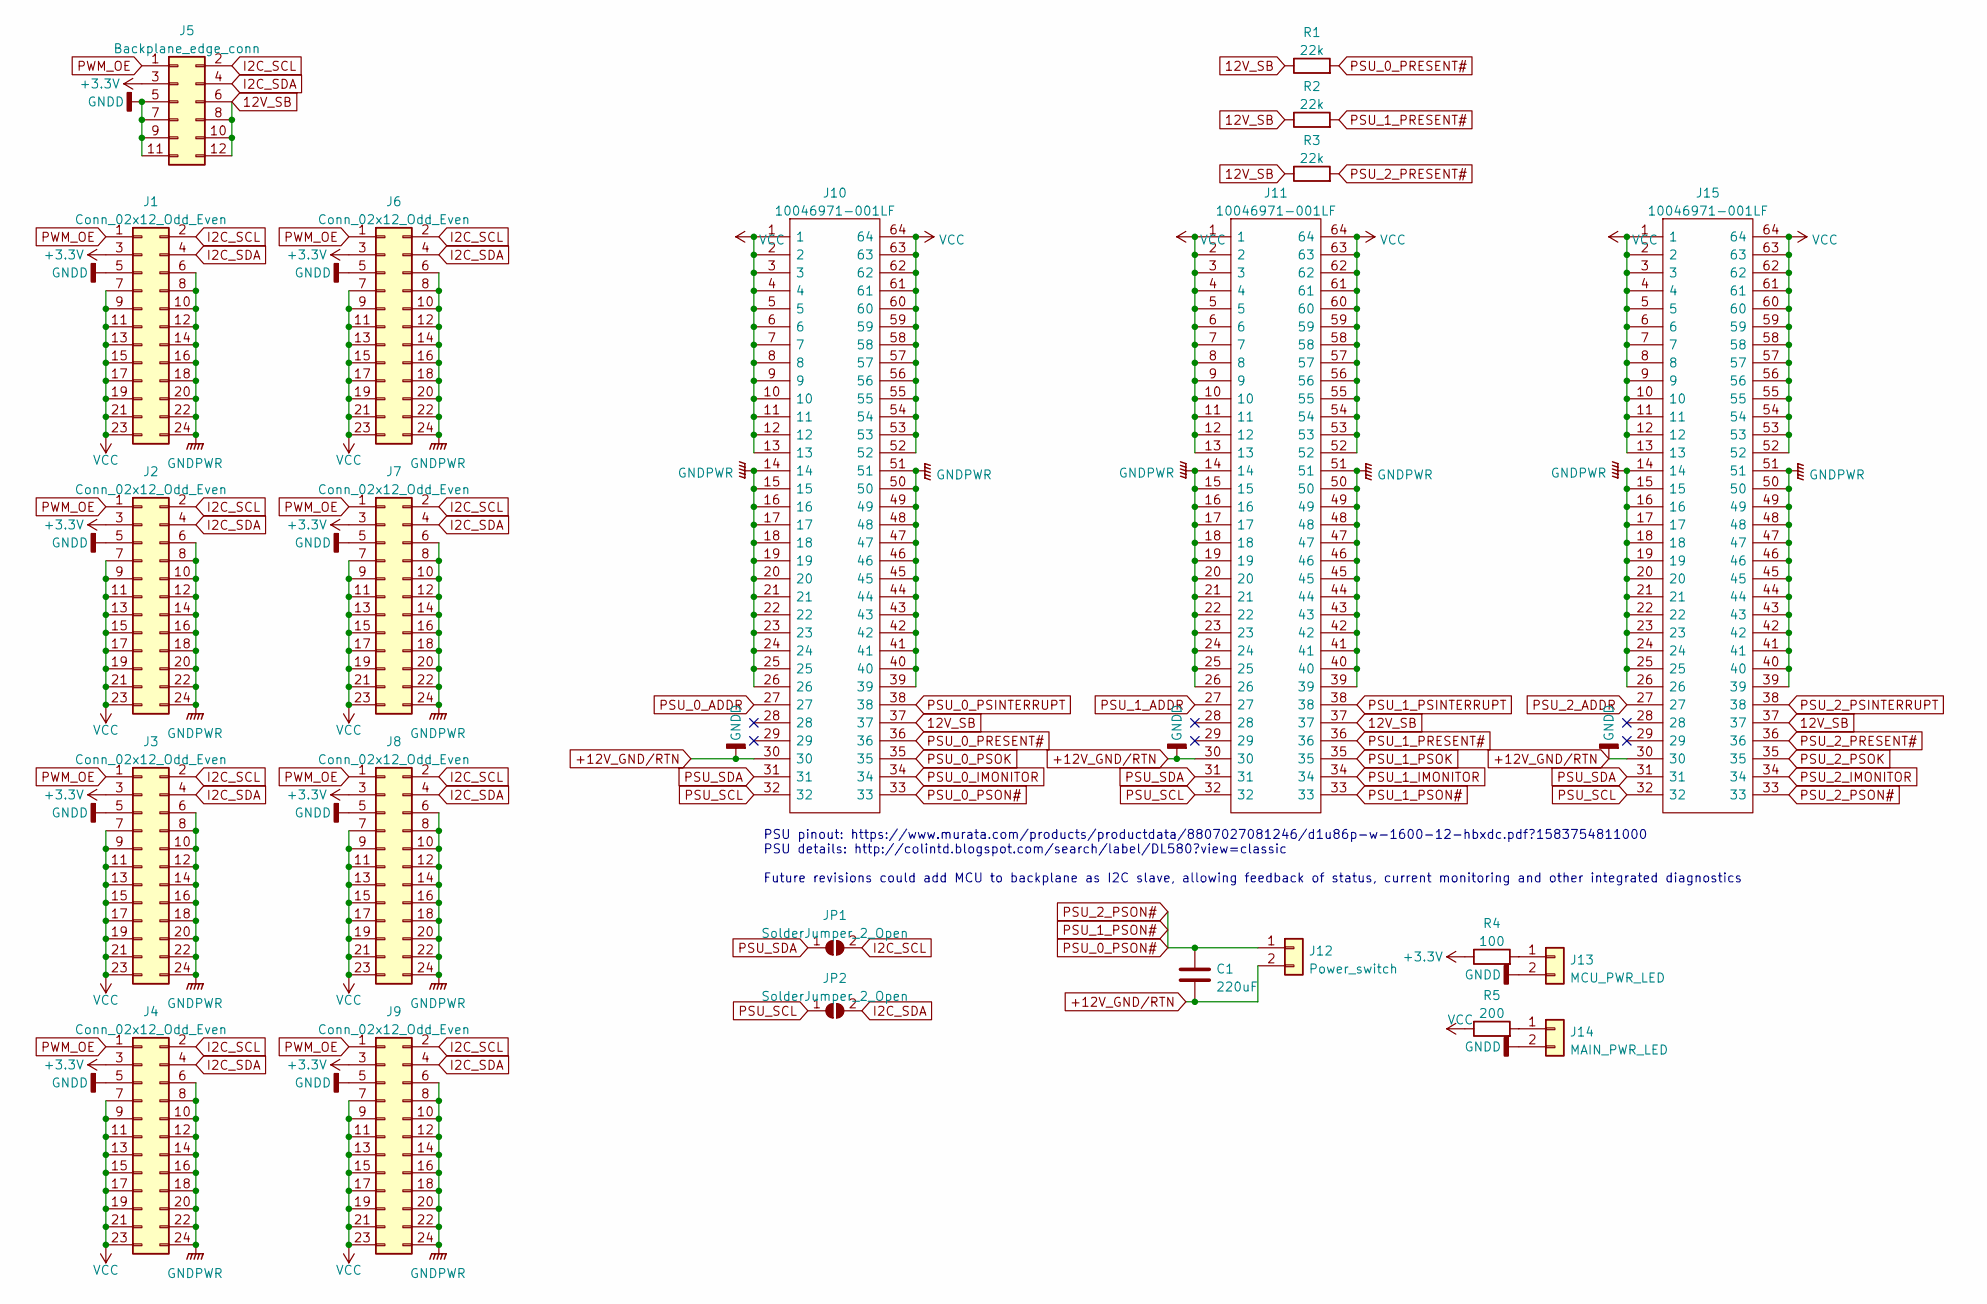
[picture p14: schematic CCC_rig_backplane.kicad_sch]

Parts:
C1: 220uF; CP_Radial_D8.0mm_P3.50mm
J1, J2, J3, J4, J6, J7, J8, J9: Conn_02x12_Odd_Even; 55308431
J5: Backplane_edge_conn; 755308435
J10, J11, J15: 10046971-001LF; RHDR64W90P508X254_2X32_8786X929X1549P; Mouser Part Number 649-10046971-001LF
J12: Power_switch; 1963531
J13: MCU_PWR_LED; 1963531
J14: MAIN_PWR_LED; 1963531
JP1, JP2: SolderJumper_2_Open; SolderJumper-2_P1.3mm_Open_RoundedPad1.0x1.5mm
R1, R2, R3: 22k; R_Axial_DIN0207_L6.3mm_D2.5mm_P7.62mm_Horizontal
R4: 100; R_Axial_DIN0207_L6.3mm_D2.5mm_P7.62mm_Horizontal
R5: 200; R_Axial_DIN0207_L6.3mm_D2.5mm_P7.62mm_Horizontal

Connections:
12V_SB: J5.6, J5.8, J5.10, J5.12, J10.37, J11.37, J15.37, R1.1, R2.1, R3.1
+3.3V: J1.3, J2.3, J3.3, J4.3, J5.3, J6.3, J7.3, J8.3, J9.3, R4.1
+12V_GND/RTN: C1.2, J1.5, J2.5, J3.5, J4.5, J5.5, J5.7, J5.9, J5.11, J6.5, J7.5, J8.5, J9.5, J10.30, J11.30, J12.2, J13.2, J14.2, J15.30
GNDPWR: J1.6, J1.8, J1.10, J1.12, J1.14, J1.16, J1.18, J1.20, J1.22, J1.24, J2.6, J2.8, J2.10, J2.12, J2.14, J2.16, J2.18, J2.20, J2.22, J2.24, J3.6, J3.8, J3.10, J3.12, J3.14, J3.16, J3.18, J3.20, J3.22, J3.24, J4.6, J4.8, J4.10, J4.12, J4.14, J4.16, J4.18, J4.20, J4.22, J4.24, J6.6, J6.8, J6.10, J6.12, J6.14, J6.16, J6.18, J6.20, J6.22, J6.24, J7.6, J7.8, J7.10, J7.12, J7.14, J7.16, J7.18, J7.20, J7.22, J7.24, J8.6, J8.8, J8.10, J8.12, J8.14, J8.16, J8.18, J8.20, J8.22, J8.24, J9.6, J9.8, J9.10, J9.12, J9.14, J9.16, J9.18, J9.20, J9.22, J9.24, J10.14, J10.15, J10.16, J10.17, J10.18, J10.19, J10.20, J10.21, J10.22, J10.23, J10.24, J10.25, J10.26, J10.39, J10.40, J10.41, J10.42, J10.43, J10.44, J10.45, J10.46, J10.47, J10.48, J10.49, J10.50, J10.51, J11.14, J11.15, J11.16, J11.17, J11.18, J11.19, J11.20, J11.21, J11.22, J11.23, J11.24, J11.25, J11.26, J11.39, J11.40, J11.41, J11.42, J11.43, J11.44, J11.45, J11.46, J11.47, J11.48, J11.49, J11.50, J11.51, J15.14, J15.15, J15.16, J15.17, J15.18, J15.19, J15.20, J15.21, J15.22, J15.23, J15.24, J15.25, J15.26, J15.39, J15.40, J15.41, J15.42, J15.43, J15.44, J15.45, J15.46, J15.47, J15.48, J15.49, J15.50, J15.51
I2C_SCL: J1.2, J2.2, J3.2, J4.2, J5.2, J6.2, J7.2, J8.2, J9.2, JP1.2 (B)
I2C_SDA: J1.4, J2.4, J3.4, J4.4, J5.4, J6.4, J7.4, J8.4, J9.4, JP2.2 (B)
unnamed: J13.1, R4.2
unnamed: J14.1, R5.2
PSU_0_ADDR: J10.27
PSU_0_IMONITOR: J10.34
PSU_0_PRESENT#: J10.36, R1.2
PSU_0_PSINTERRUPT: J10.38
PSU_0_PSOK: J10.35
PSU_0_PSON#: C1.1, J10.33, J11.33, J12.1, J15.33
PSU_1_ADDR: J11.27
PSU_1_IMONITOR: J11.34
PSU_1_PRESENT#: J11.36, R2.2
PSU_1_PSINTERRUPT: J11.38
PSU_1_PSOK: J11.35
PSU_2_ADDR: J15.27
PSU_2_IMONITOR: J15.34
PSU_2_PRESENT#: J15.36, R3.2
PSU_2_PSINTERRUPT: J15.38
PSU_2_PSOK: J15.35
PSU_SCL: J10.32, J11.32, J15.32, JP2.1 (A)
PSU_SDA: J10.31, J11.31, J15.31, JP1.1 (A)
PWM_OE: J1.1, J2.1, J3.1, J4.1, J5.1, J6.1, J7.1, J8.1, J9.1
VCC: J1.7, J1.9, J1.11, J1.13, J1.15, J1.17, J1.19, J1.21, J1.23, J2.7, J2.9, J2.11, J2.13, J2.15, J2.17, J2.19, J2.21, J2.23, J3.7, J3.9, J3.11, J3.13, J3.15, J3.17, J3.19, J3.21, J3.23, J4.7, J4.9, J4.11, J4.13, J4.15, J4.17, J4.19, J4.21, J4.23, J6.7, J6.9, J6.11, J6.13, J6.15, J6.17, J6.19, J6.21, J6.23, J7.7, J7.9, J7.11, J7.13, J7.15, J7.17, J7.19, J7.21, J7.23, J8.7, J8.9, J8.11, J8.13, J8.15, J8.17, J8.19, J8.21, J8.23, J9.7, J9.9, J9.11, J9.13, J9.15, J9.17, J9.19, J9.21, J9.23, J10.1, J10.2, J10.3, J10.4, J10.5, J10.6, J10.7, J10.8, J10.9, J10.10, J10.11, J10.12, J10.13, J10.52, J10.53, J10.54, J10.55, J10.56, J10.57, J10.58, J10.59, J10.60, J10.61, J10.62, J10.63, J10.64, J11.1, J11.2, J11.3, J11.4, J11.5, J11.6, J11.7, J11.8, J11.9, J11.10, J11.11, J11.12, J11.13, J11.52, J11.53, J11.54, J11.55, J11.56, J11.57, J11.58, J11.59, J11.60, J11.61, J11.62, J11.63, J11.64, J15.1, J15.2, J15.3, J15.4, J15.5, J15.6, J15.7, J15.8, J15.9, J15.10, J15.11, J15.12, J15.13, J15.52, J15.53, J15.54, J15.55, J15.56, J15.57, J15.58, J15.59, J15.60, J15.61, J15.62, J15.63, J15.64, R5.1

Notes on the sheet:
PSU pinout: https://www.murata.com/products/productdata/8807027081246/d1u86p-w-1600-12-hbxdc.pdf?1583754811000 PSU details: http://colintd.blogspot.com/search/label/DL580?view=classic Future revisions could add MCU to backplane as I2C slave, allowing feedback of status, current monitoring and other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

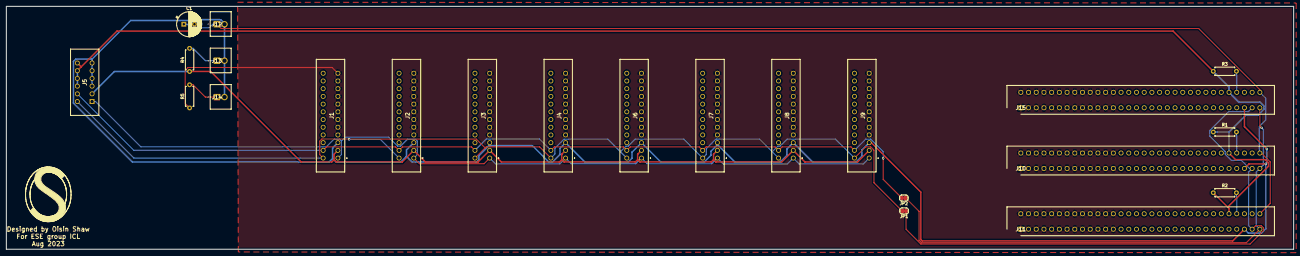
[picture p15: board CCC_rig_backplane.kicad_pcb from above]

Board: 2 copper layers, 424.0 x 80.0 mm, 23 parts (0 on the bottom side), 16 nets.
