OisinS13/Peltier_rig/(commit log)

2023-11-01 Send absolute PID values to PWM drivers
2023-11-01 Command functions update existing values, implement PID settings directly
